TERA-TU-Graz/fennek_2019/HW/pcbs/other/button_interface/button_interface.png

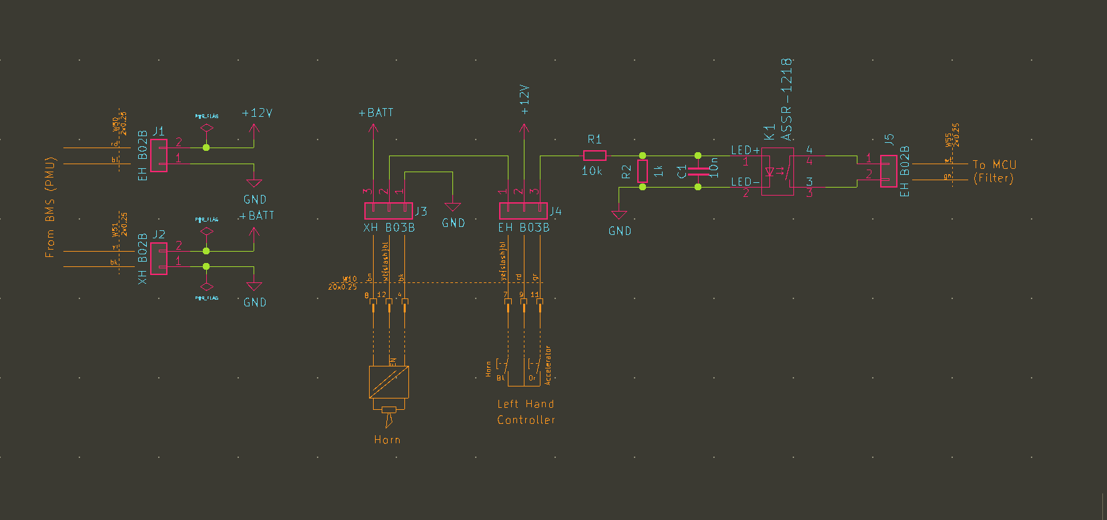
HW/pcbs/other/button_interface/button_interface.png
