TERA-TU-Graz/fennek_2019/HW/pcbs/motor/V8/Motor-Control-board-V8_1_KiCAD/gerber/Motor_Control-B.Cu.pdf

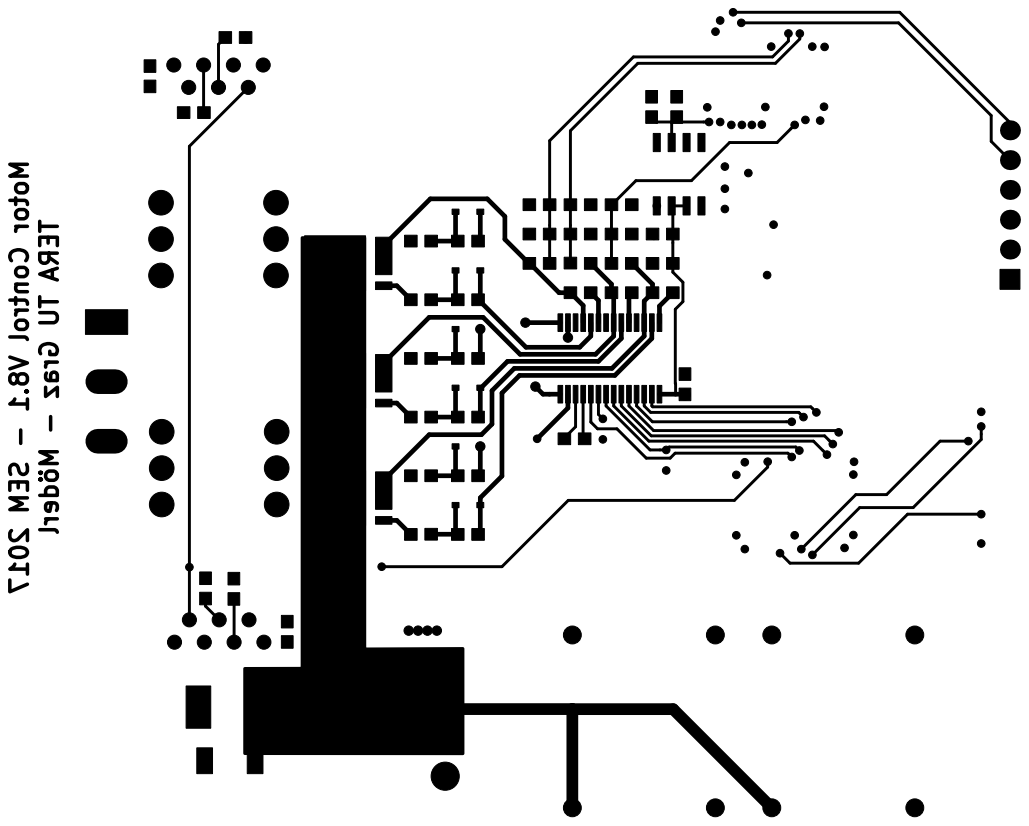
[picture p2: page 1]

Motor Control V8.1 - SEM 2017 TERA TU Graz - Möderl
