TERA-TU-Graz/fennek_2019/HW/pcbs/motor/V8/Motor-Control-board-V8_1_KiCAD/gerber/Motor_Control-B.Mask.pdf

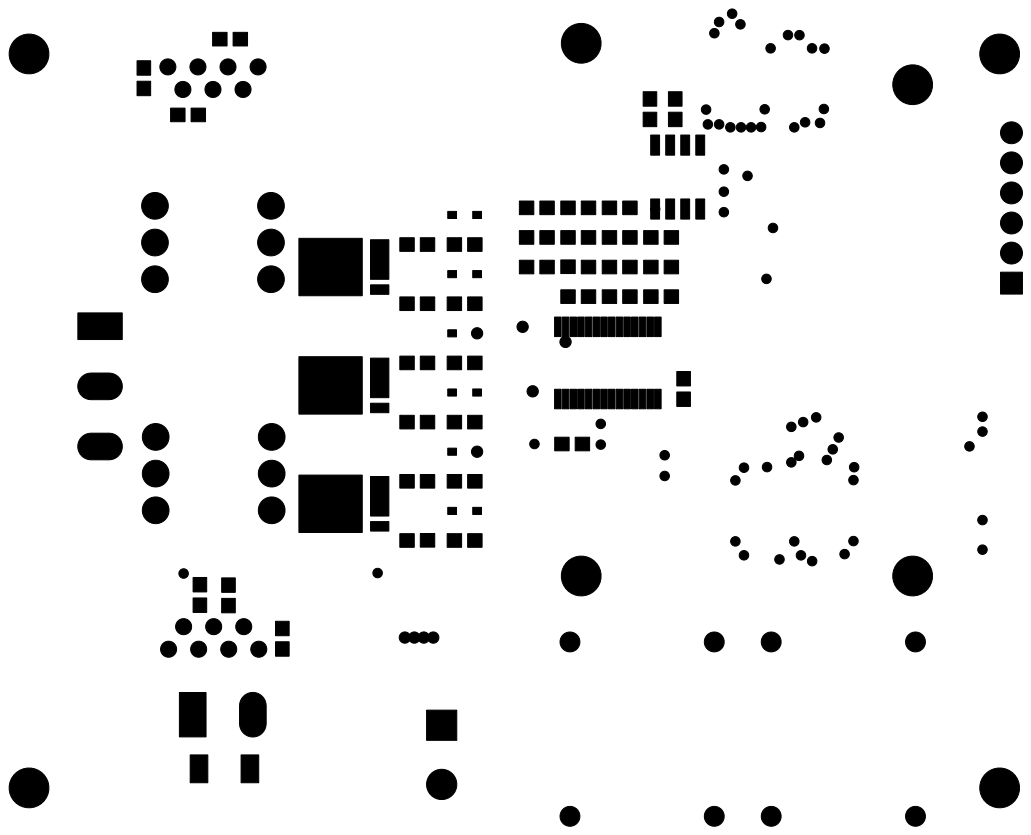
[picture p3: page 1]
