TERA-TU-Graz/fennek_2019/HW/pcbs/motor/V8/Motor-Control-board-V8_1_KiCAD/gerber/Motor_Control-F.Cu.pdf

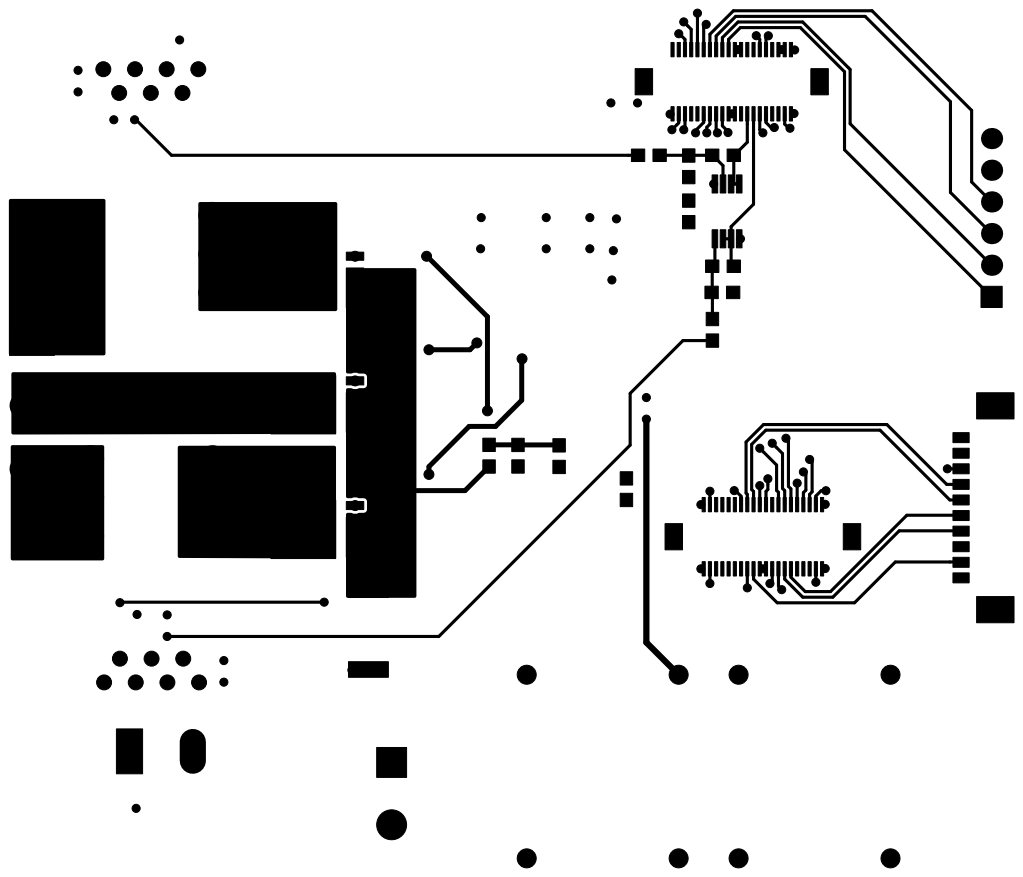
[picture p5: page 1]
