TERA-TU-Graz/fennek_2019/HW/pcbs/BMS/measurement_and_balancing/bms_board_V6-1__12s_fennek2017/bms_board.kicad_pcb

## KiCad design HW/pcbs/BMS/measurement_and_balancing/bms_board_V6-1__12s_fennek2017/bms_board.kicad_pcb (2020-02-26)

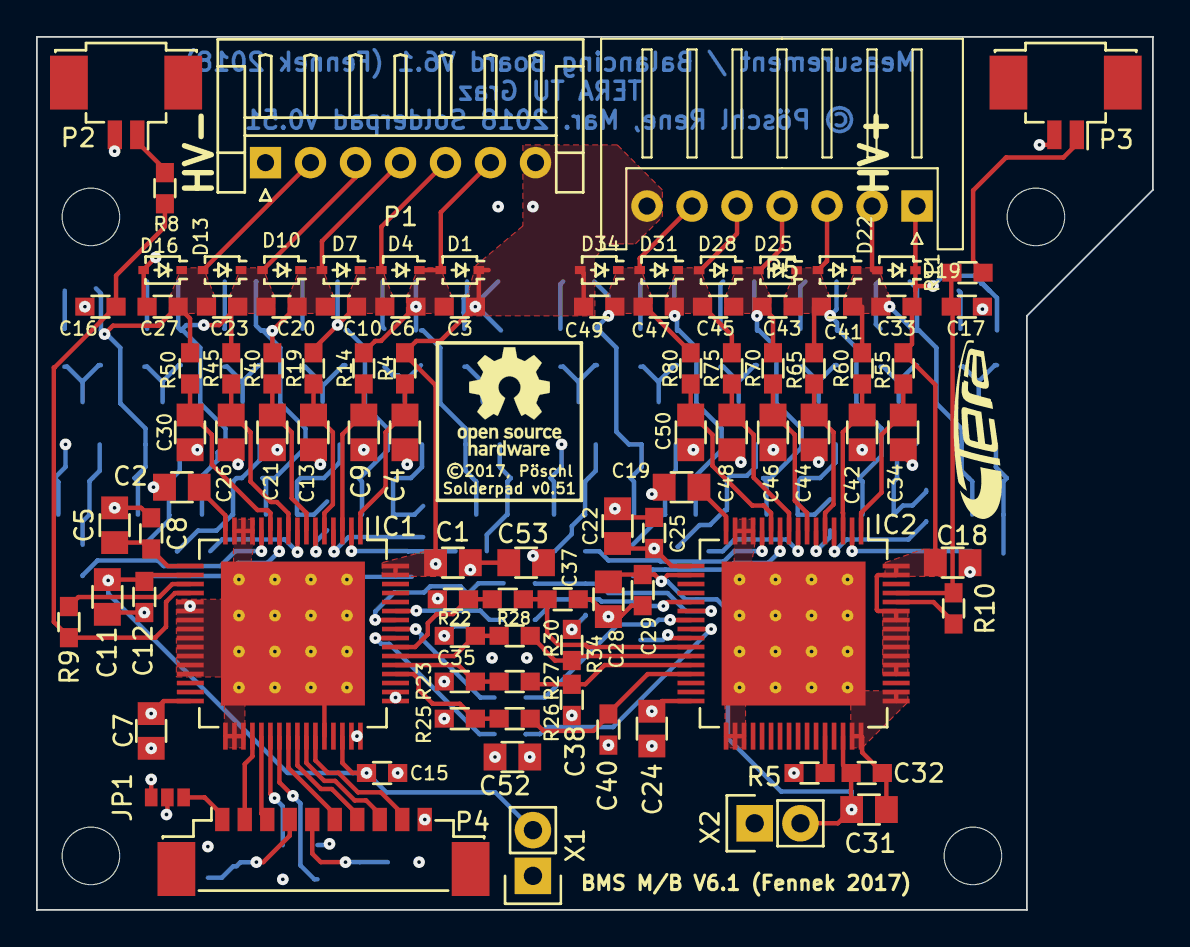
[picture p10: board bms_board.kicad_pcb from above]

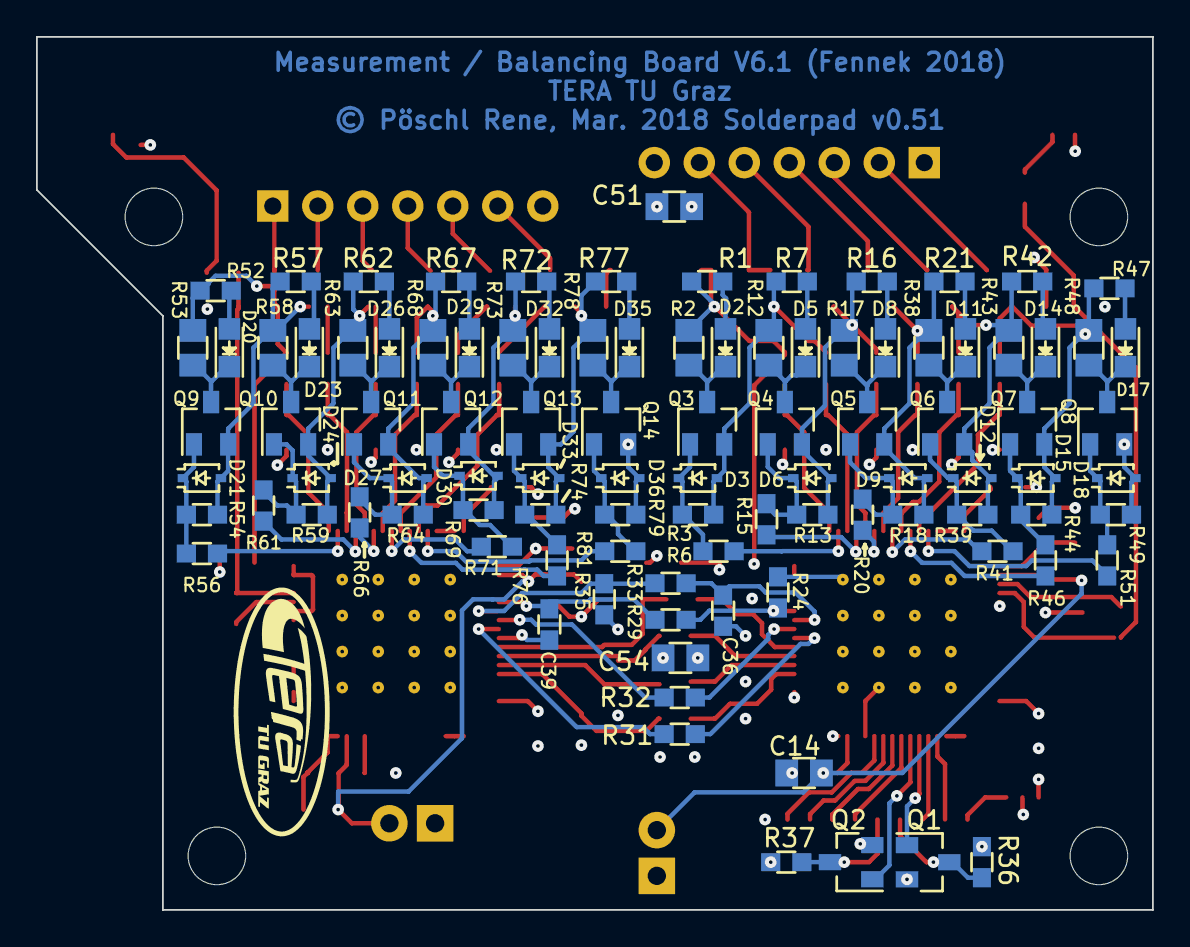
[picture p11: board bms_board.kicad_pcb from below]

Board: 4 copper layers, 62.0 x 48.5 mm, 197 parts (100 on the bottom side), 116 nets.

Parts:
C1, C4, C9, C13, C18, C21, C26, C30, C34, C42, C44, C46, C48, C50, C51, C52, C53, C54: 100n 50V; C_0805in
C2, C19: 10u; C_0805in
C3, C6, C8, C10, C12, C15, C20, C23, C25, C27, C29, C32, C33, C41, C43, C45, C47, C49: 100n; C_0603in
C5, C7, C11, C14, C22, C24, C28, C31: 2.2u; C_0805in
C16, C17: 47n; C_0603in
C35, C36, C37, C38, C39, C40: 33p; C_0603in
D1, D3, D4, D6, D7, D9, D10, D12, D13, D15, D16, D18, D19, D21, D22, D24, D25, D27, D28, D30, D31, D33, D34, D36: 5.1V; SOD-323
D2, D5, D8, D11, D14, D17, D20, D23, D26, D29, D32, D35: LED; LED_0805
IC1, IC2: TI-bq76pl536; TI_bq76PL536
JP1: JUMPER3_NO; SOLDERJUMPER_3_1mm
P1: CONN_01X07; JST_EH_S07B-EH_07x2.50mm_Angled
P2: TS1; Molex_PicoBlade_53261-0271_02x1.25mm_Angled
P3: TS2; Molex_PicoBlade_53261-0271_02x1.25mm_Angled
P4: Host_Interface; Molex_PicoBlade_53398-1071_10x1.25mm_Straight
P5: CONN_01X07; JST_XH_S07B-XH-A_07x2.50mm_Angled
Q1, Q2, Q3, Q4, Q5, Q6, Q7, Q8, Q9, Q10, Q11, Q12, Q13, Q14: BSS205N
R1, R7, R16, R21, R42, R47, R52, R57, R62, R67, R72, R77: 2K2; R_0603in
R2, R12, R17, R38, R43, R48, R53, R58, R63, R68, R73, R78: 180R; R_0805in
R3, R13, R18, R22, R23, R24, R25, R39, R44, R49, R54, R59, R64, R69, R74, R79: 2M; R_0603in
R4, R6, R14, R15, R19, R20, R26, R27, R28, R29, R30, R31, R32, R33, R40, R41, R45, R46, R50, R51, R55, R56, R60, R61, R65, R66, R70, R71, R75, R76, R80, R81: 1K; R_0603in
R5: 100K; R_0603in
R8, R11: 1.47K; R_0603in
R9, R10: 1.82K; R_0603in
R34, R35: 510K; R_0603in
R36, R37: 10K; R_0603in
X1, X2: Prog_Voltage; Socket_Strip_Straight_1x02
svg2mod: G***; TERA_Logo_SilkS_5x12.5mm
svg2mod#2: G***; TERA_TextOnly_SilkS_2.5x9.5mm

Connections:
+5V: C7.1, C16.1, IC1.32, JP1.1, P2.2
+BATT: C18.2, C33.1, D19.1, IC2.52, IC2.53, IC2.54, IC2.55, IC2.56, IC2.57, IC2.58, IC2.59, IC2.63, IC2.64, P5.1, R52.1, R53.1, R55.2
/5V_C2: C17.1, C24.1, IC2.32, P3.2, R34.1, R35.1
/Chip1/+5V_LDOA: C5.1, C8.1, IC1.17
/Chip1/Alert_H: IC1.38, Q1.1
/Chip1/BalanceCell1/VCn: C30.1, IC1.11, R50.1
/Chip1/BalanceCell2/VCn: C26.1, IC1.9, R45.1
/Chip1/BalanceCell3/VCn: C21.1, IC1.7, R40.1
/Chip1/BalanceCell4/VCn: C13.1, IC1.5, R19.1
/Chip1/BalanceCell5/VCn: C9.1, IC1.3, R14.1
/Chip1/BalanceCell6/VCn: C4.1, IC1.1, R4.1
/Chip1/CB1: IC1.12, R51.1
/Chip1/CB2: IC1.10, R46.1
/Chip1/CB3: IC1.8, R41.1
/Chip1/CB4: IC1.6, R20.1
/Chip1/CB5: IC1.4, R15.1
/Chip1/CB6: IC1.2, R6.1
/Chip1/CONV_H: IC1.36, P4.2
/Chip1/CS_H: IC1.43, P4.9
/Chip1/DRDY_H: IC1.37, P4.3
/Chip1/Fault_H: IC1.39, Q2.1
/Chip1/LDODx: C11.1, C12.1, C14.1, C15.1, IC1.18, IC1.46, X1.2
/Chip1/SCLK_H: IC1.40, P4.6
/Chip1/SDI_H: IC1.42, P4.8
/Chip1/SDO_H: IC1.41, P4.7
/Chip1/TS1+: C16.2, IC1.20, R8.1, R9.1
/Chip1/TS1-: IC1.19, R9.2
/Chip1/VC1: C23.2, C27.1, D13.2, D15.2, D16.1, P1.2, Q7.2, R44.2, R47.1, R48.1, R50.2
/Chip1/VC2: C20.2, C23.1, D10.2, D12.2, D13.1, P1.3, Q6.2, R39.2, R42.1, R43.1, R45.2
/Chip1/VC3: C10.2, C20.1, D7.2, D9.2, D10.1, P1.4, Q5.2, R18.2, R21.1, R38.1, R40.2
/Chip1/VC4: C6.2, C10.1, D4.2, D6.2, D7.1, P1.5, Q4.2, R13.2, R16.1, R17.1, R19.2
/Chip1/VC5: C3.2, C6.1, D1.2, D3.2, D4.1, P1.6, Q3.2, R3.2, R7.1, R12.1, R14.2
/Chip2/+5V_LDOA: C22.1, C25.1, IC2.17, R5.1
/Chip2/BalanceCell1/VCn: C50.1, IC2.11, R80.1
/Chip2/BalanceCell2/VCn: C48.1, IC2.9, R75.1
/Chip2/BalanceCell3/VCn: C46.1, IC2.7, R70.1
/Chip2/BalanceCell4/VCn: C44.1, IC2.5, R65.1
/Chip2/BalanceCell5/VCn: C42.1, IC2.3, R60.1
/Chip2/BalanceCell6/VCn: C34.1, IC2.1, R55.1
/Chip2/CB1: IC2.12, R81.1
/Chip2/CB2: IC2.10, R76.1
/Chip2/CB3: IC2.8, R71.1
/Chip2/CB4: IC2.6, R66.1
/Chip2/CB5: IC2.4, R61.1
/Chip2/CB6: IC2.2, R56.1
/Chip2/HSEL: IC2.44, R5.2
/Chip2/LDODx: C28.1, C29.1, C31.1, C32.1, IC2.18, IC2.46, X2.2
/Chip2/TS2+: C17.2, IC2.61, R10.1, R11.1
/Chip2/TS2-: IC2.60, R10.2
/Chip2/VC1: C47.2, C49.1, D31.2, D33.2, D34.1, P5.6, Q13.2, R74.2, R77.1, R78.1, R80.2
/Chip2/VC2: C45.2, C47.1, D28.2, D30.2, D31.1, P5.5, Q12.2, R69.2, R72.1, R73.1, R75.2
/Chip2/VC3: C43.2, C45.1, D25.2, D27.2, D28.1, P5.4, Q11.2, R64.2, R67.1, R68.1, R70.2
/Chip2/VC4: C41.2, C43.1, D22.2, D24.2, D25.1, P5.3, Q10.2, R59.2, R62.1, R63.1, R65.2
/Chip2/VC5: C33.2, C41.1, D19.2, D21.2, D22.1, P5.2, Q9.2, R54.2, R57.1, R58.1, R60.2
/Daisychain/Alert_1: IC1.57, R32.1
/Daisychain/Alert_2: IC2.23, R32.2
/Daisychain/CONV_1: IC1.59, R24.2, R29.1
/Daisychain/CONV_2: C39.1, IC2.21, R29.2
/Daisychain/CS_1: IC1.52, R25.2, R26.1
/Daisychain/CS_2: C40.1, IC2.29, R26.2
/Daisychain/DRDY_1: C36.2, IC1.58, R33.1
/Daisychain/DRDY_2: IC2.22, R33.2, R35.2
/Daisychain/Fault_1: IC1.56, R31.1
/Daisychain/Fault_2: IC2.24, R31.2
/Daisychain/SCLK_1: IC1.55, R22.2, R28.1
/Daisychain/SCLK_2: C37.1, IC2.26, R28.2
/Daisychain/SDI_1: IC1.53, R23.2, R27.1
/Daisychain/SDI_2: C38.1, IC2.28, R27.2
/Daisychain/SDO_1: C35.2, IC1.54, R30.1
/Daisychain/SDO_2: IC2.27, R30.2, R34.2
/Host_connect/+5V_DO: JP1.2, R36.1, R37.1
/Host_connect/+5V_Host: JP1.3, P4.1
/Host_connect/NALERT_H: P4.4, Q1.3, R36.2
/Host_connect/NFAULT_H: P4.5, Q2.3, R37.2
GND: C1.1, C2.2, C4.2, C5.2, C7.2, C8.2, C9.2, C11.2, C12.2, C13.2, C14.2, C15.2, C21.2, C26.2, C27.2, C30.2, C51.2, C52.2, C53.2, C54.2, D16.2, D18.2, IC1.13, IC1.14, IC1.15, IC1.21, IC1.22, IC1.23, IC1.24, IC1.25, IC1.26, IC1.27, IC1.28, IC1.29, IC1.33, IC1.34, IC1.35, IC1.44, IC1.47, IC1.48, IC1.49, IC1.50, IC1.65, P1.1, P4.10, Q1.2, Q2.2, Q8.2, R22.1, R23.1, R24.1, R25.1, R49.2, X1.1
unnamed: C2.1, IC1.16
unnamed: C19.1, IC2.16
unnamed: D2.1, Q3.3, R2.2
unnamed: D2.2, R1.2
unnamed: D3.1, Q3.1, R3.1, R6.2
unnamed: D5.1, Q4.3, R12.2
unnamed: D5.2, R7.2
unnamed: D6.1, Q4.1, R13.1, R15.2
unnamed: D8.1, Q5.3, R17.2
unnamed: D8.2, R16.2
unnamed: D9.1, Q5.1, R18.1, R20.2
unnamed: D11.1, Q6.3, R38.2
unnamed: D11.2, R21.2
unnamed: D12.1, Q6.1, R39.1, R41.2
unnamed: D14.1, Q7.3, R43.2
unnamed: D14.2, R42.2
unnamed: D15.1, Q7.1, R44.1, R46.2
unnamed: D17.1, Q8.3, R48.2
unnamed: D17.2, R47.2
unnamed: D18.1, Q8.1, R49.1, R51.2
unnamed: D20.1, Q9.3, R53.2
unnamed: D20.2, R52.2
unnamed: D21.1, Q9.1, R54.1, R56.2
unnamed: D23.1, Q10.3, R58.2
unnamed: D23.2, R57.2
unnamed: D24.1, Q10.1, R59.1, R61.2
unnamed: D26.1, Q11.3, R63.2
unnamed: D26.2, R62.2
unnamed: D27.1, Q11.1, R64.1, R66.2
unnamed: D29.1, Q12.3, R68.2
unnamed: D29.2, R67.2
unnamed: D30.1, Q12.1, R69.1, R71.2
unnamed: D32.1, Q13.3, R73.2
unnamed: D32.2, R72.2
unnamed: D33.1, Q13.1, R74.1, R76.2
unnamed: D35.1, Q14.3, R78.2
unnamed: D35.2, R77.2
unnamed: D36.1, Q14.1, R79.1, R81.2
unnamed: P2.1, R8.2
unnamed: P3.1, R11.2
Vmiddle: C1.2, C3.1, C18.1, C19.2, C22.2, C24.2, C25.2, C28.2, C29.2, C31.2, C32.2, C34.2, C35.1, C36.1, C37.2, C38.2, C39.2, C40.2, C42.2, C44.2, C46.2, C48.2, C49.2, C50.2, C51.1, C52.1, C53.1, C54.1, D1.1, D34.2, D36.2, IC1.63, IC1.64, IC2.13, IC2.14, IC2.15, IC2.25, IC2.33, IC2.34, IC2.35, IC2.47, IC2.48, IC2.49, IC2.50, IC2.65, P1.7, P5.7, Q14.2, R1.1, R2.1, R4.2, R79.2, X2.1
