TERA-TU-Graz/fennek_2019/HW/pcbs/motor/V8/Motor-Control-board-V8_1_KiCAD/Motor_Control.kicad_pcb

## KiCad design HW/pcbs/motor/V8/Motor-Control-board-V8_1_KiCAD/Motor_Control.kicad_pcb (2020-02-26, an earlier design)

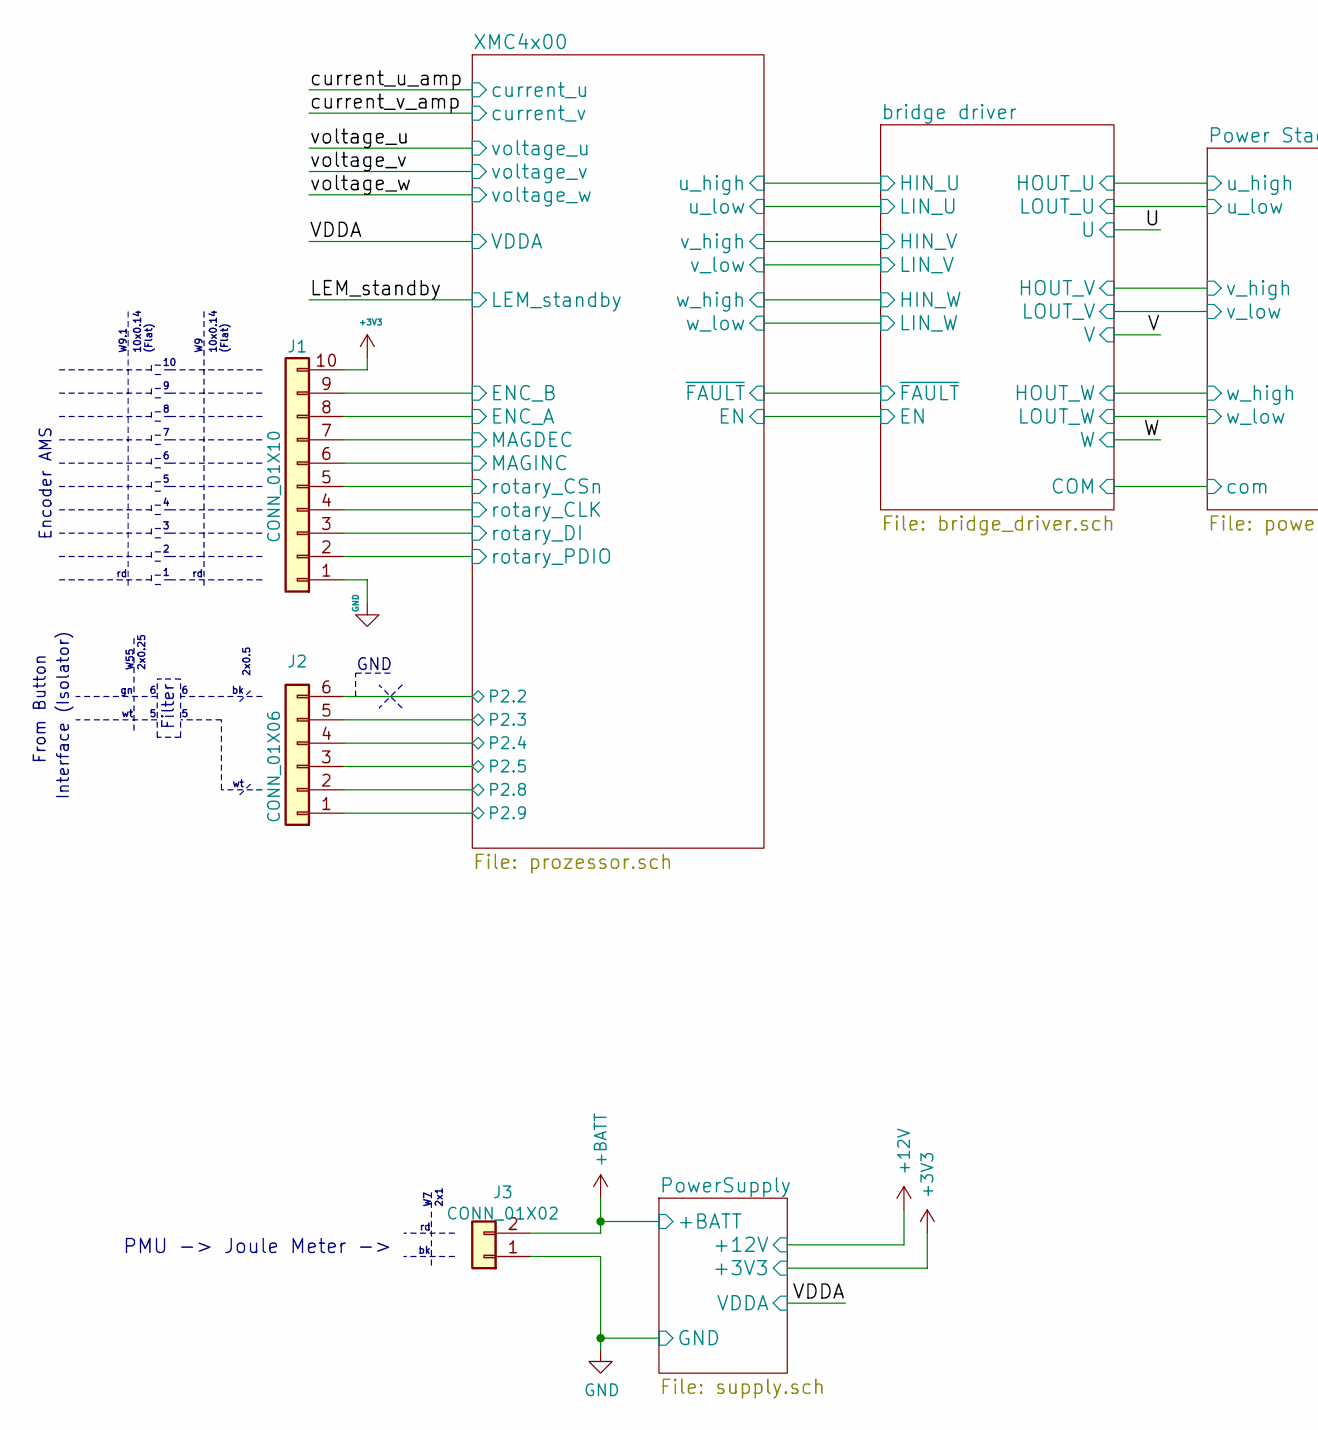
[picture p12: schematic Motor_Control.sch, Motor Control, part in row 1, column 1]

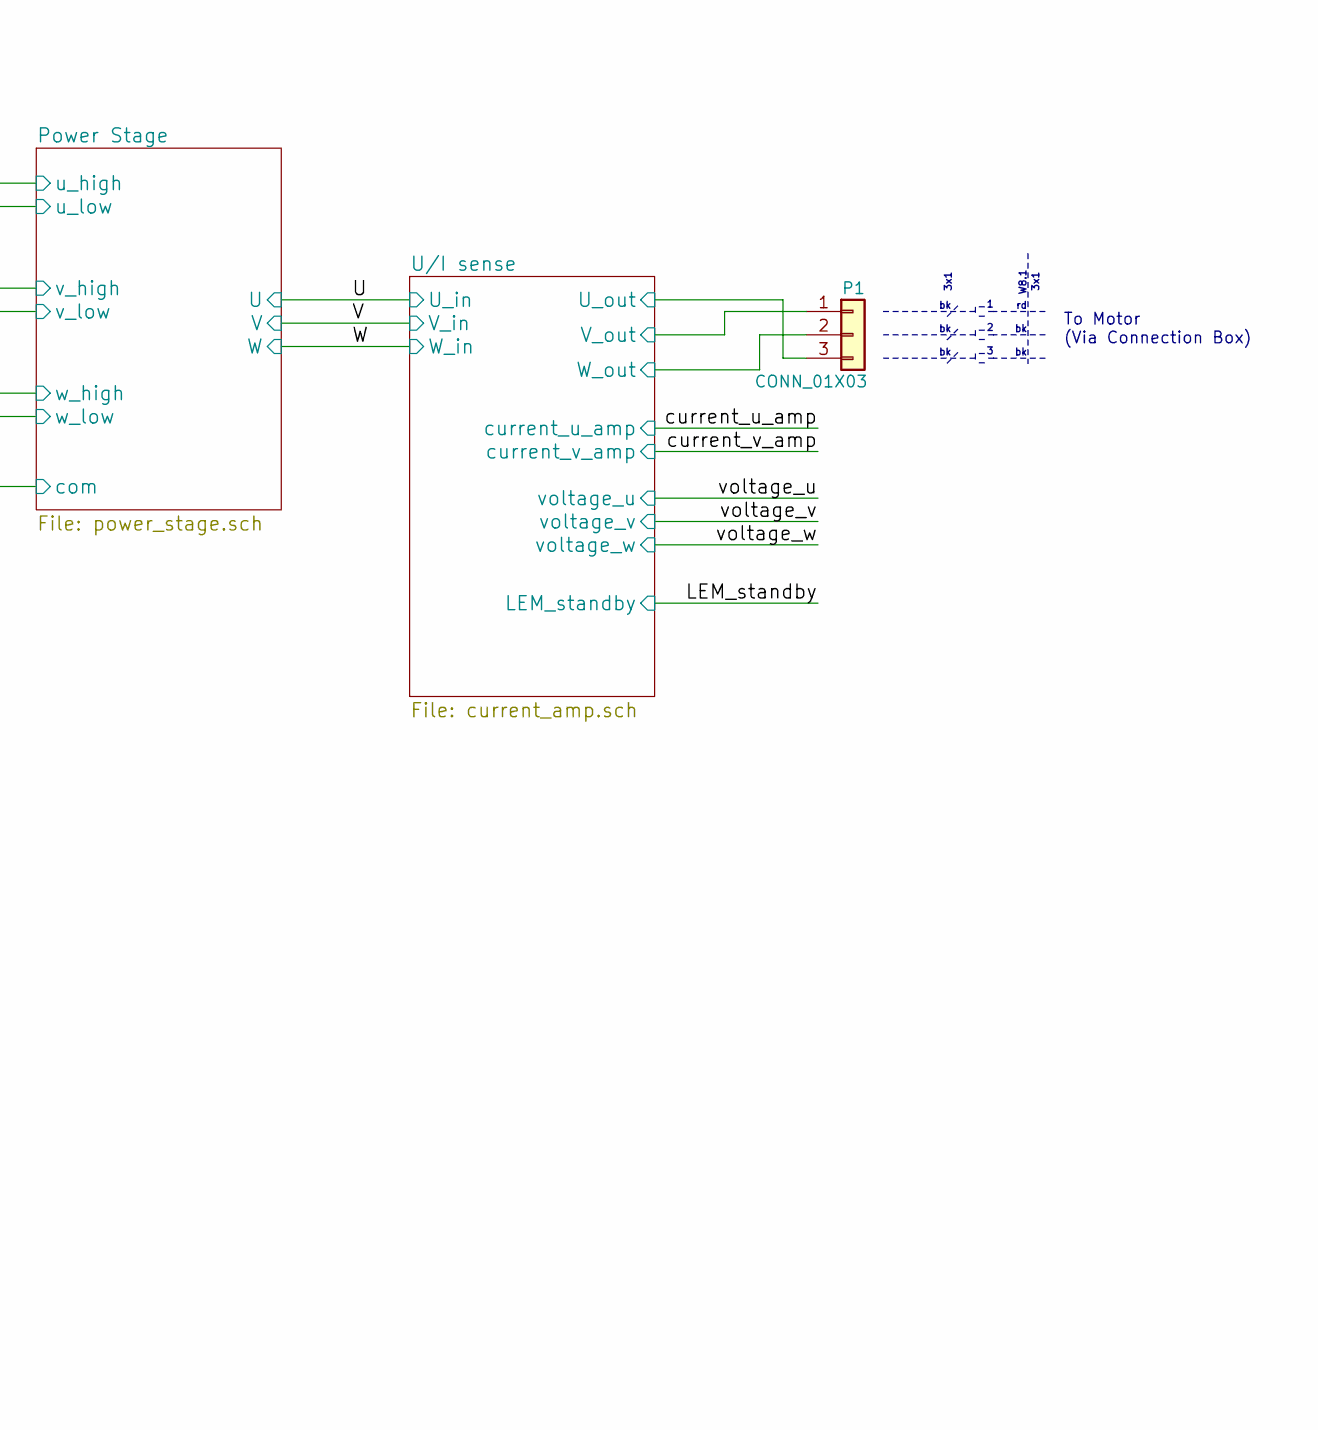
[picture p13: schematic Motor_Control.sch, Motor Control, part in row 1, column 2]

Parts:
J1: CONN_01X10; Molex_PicoBlade_53398-1071_10x1.25mm_Straight
J2: CONN_01X06; Pin_Header_Straight_1x06_Pitch2.54mm
J3: CONN_01X02; PhoenixContact_MSTB-GF_02x5.08mm_Angled_ThreadedFlange
P1: CONN_01X03; PhoenixContact_MSTBA-G_03x5.08mm_Angled

Connections:
+3V3: J1.10; also elsewhere on the board
+BATT: J3.2; also elsewhere on the board
<root sheet>ENC_A: J1.8; also elsewhere on the board
<root sheet>ENC_B: J1.9; also elsewhere on the board
<root sheet>MAGDEC: J1.7; also elsewhere on the board
<root sheet>MAGINC: J1.6; also elsewhere on the board
<root sheet>U_out: P1.3; also elsewhere on the board
<root sheet>V_out: P1.1; also elsewhere on the board
<root sheet>W_out: P1.2; also elsewhere on the board
<root sheet>rotary_CLK: J1.4; also elsewhere on the board
<root sheet>rotary_CSn: J1.5; also elsewhere on the board
<root sheet>rotary_DI: J1.3; also elsewhere on the board
<root sheet>rotary_PDIO: J1.2; also elsewhere on the board
GND: J1.1, J3.1; also elsewhere on the board
unnamed 58: J2.1; also elsewhere on the board
unnamed 59: J2.2; also elsewhere on the board
unnamed 60: J2.3; also elsewhere on the board
unnamed 61: J2.4; also elsewhere on the board
unnamed 62: J2.5; also elsewhere on the board
unnamed 63: J2.6; also elsewhere on the board

Notes on the sheet:
10x0.14 (Flat)
W9.1
Encoder AMS
3x1
W8.1
To Motor (Via Connection Box)
PMU -> Joule Meter ->
2x1
GND
2x0.5
Filter
From Button
Interface (Isolator)
2x0.25
W55

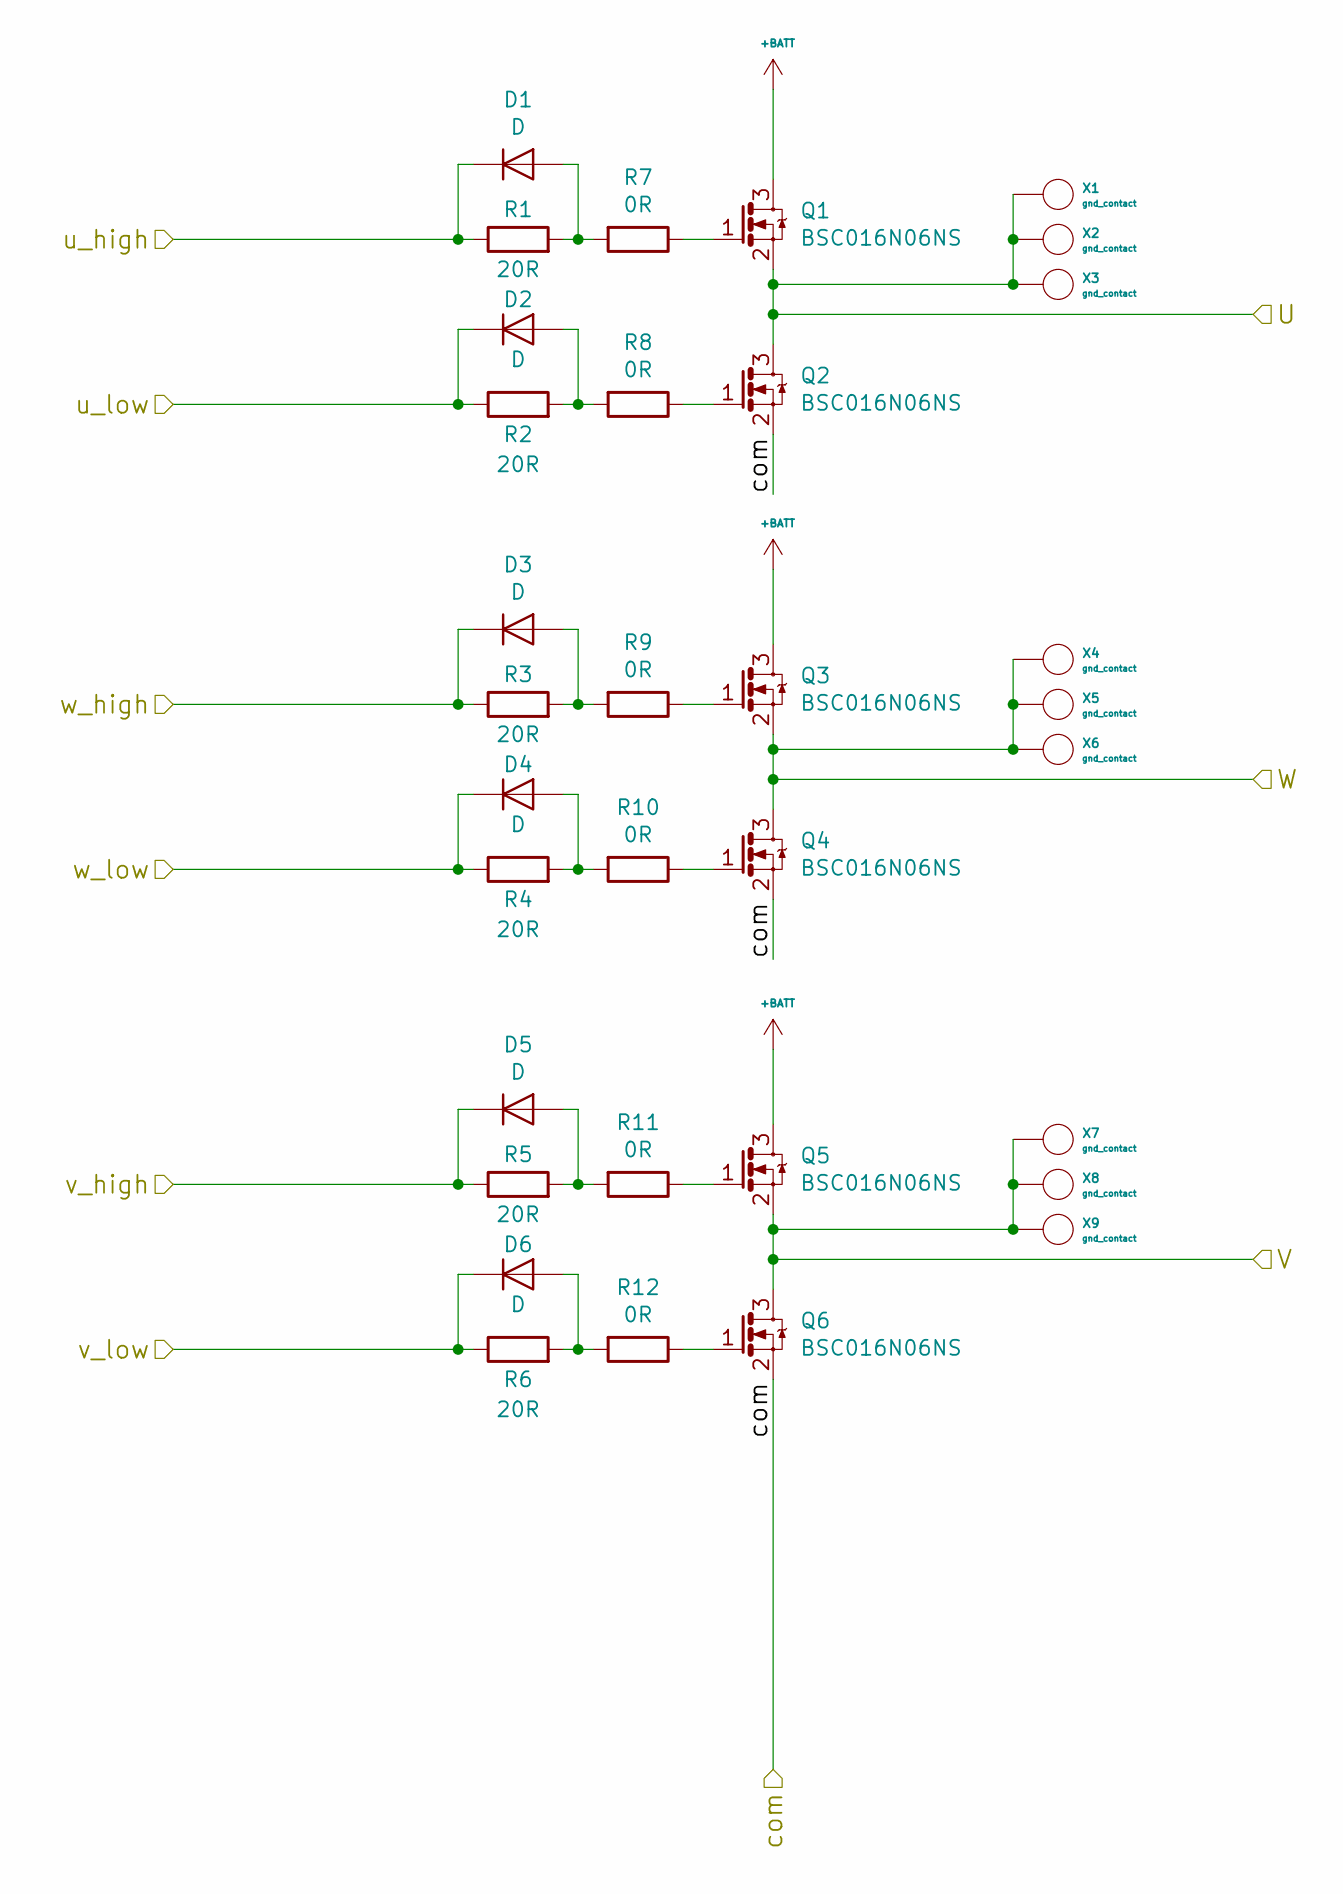
[picture p14: schematic power_stage.sch, Motor Control]

Parts:
D1, D2, D3, D4, D5, D6: D; SOD-323
Q1, Q2, Q3, Q4, Q5, Q6: BSC016N06NS; INF-PG-TDSON-8
R1, R2, R3, R4, R5, R6: 20R; R_0603in
R7, R8, R9, R10, R11, R12: 0R; R_0603in
X1, X2, X3, X4, X5, X6, X7, X8, X9: gnd_contact; via_0.4mm

Connections:
+BATT: Q1.3 (D), Q3.3 (D), Q5.3 (D); also elsewhere on the board
<root sheet>COM: Q2.2 (S), Q4.2 (S), Q6.2 (S); also elsewhere on the board
<root sheet>HOUT_V: D5.1 (K), R5.1; also elsewhere on the board
<root sheet>LOUT_V: D6.1 (K), R6.1; also elsewhere on the board
<root sheet>U: Q1.2 (S), Q2.3 (D), X1.1, X2.1, X3.1; also elsewhere on the board
<root sheet>V: Q5.2 (S), Q6.3 (D), X7.1, X8.1, X9.1; also elsewhere on the board
<root sheet>W_out: Q3.2 (S), Q4.3 (D), X4.1, X5.1, X6.1; also elsewhere on the board
<root sheet>u_high: D1.1 (K), R1.1; also elsewhere on the board
<root sheet>u_low: D2.1 (K), R2.1; also elsewhere on the board
<root sheet>w_high: D3.1 (K), R3.1; also elsewhere on the board
<root sheet>w_low: D4.1 (K), R4.1; also elsewhere on the board
unnamed: D1.2 (A), R1.2, R7.2
unnamed: D2.2 (A), R2.2, R8.2
unnamed: D3.2 (A), R3.2, R9.2
unnamed: D4.2 (A), R4.2, R10.2
unnamed: D5.2 (A), R5.2, R11.2
unnamed: D6.2 (A), R6.2, R12.2
unnamed: Q1.1 (G), R7.1
unnamed: Q2.1 (G), R8.1
unnamed: Q3.1 (G), R9.1
unnamed: Q4.1 (G), R10.1
unnamed: Q5.1 (G), R11.1
unnamed: Q6.1 (G), R12.1

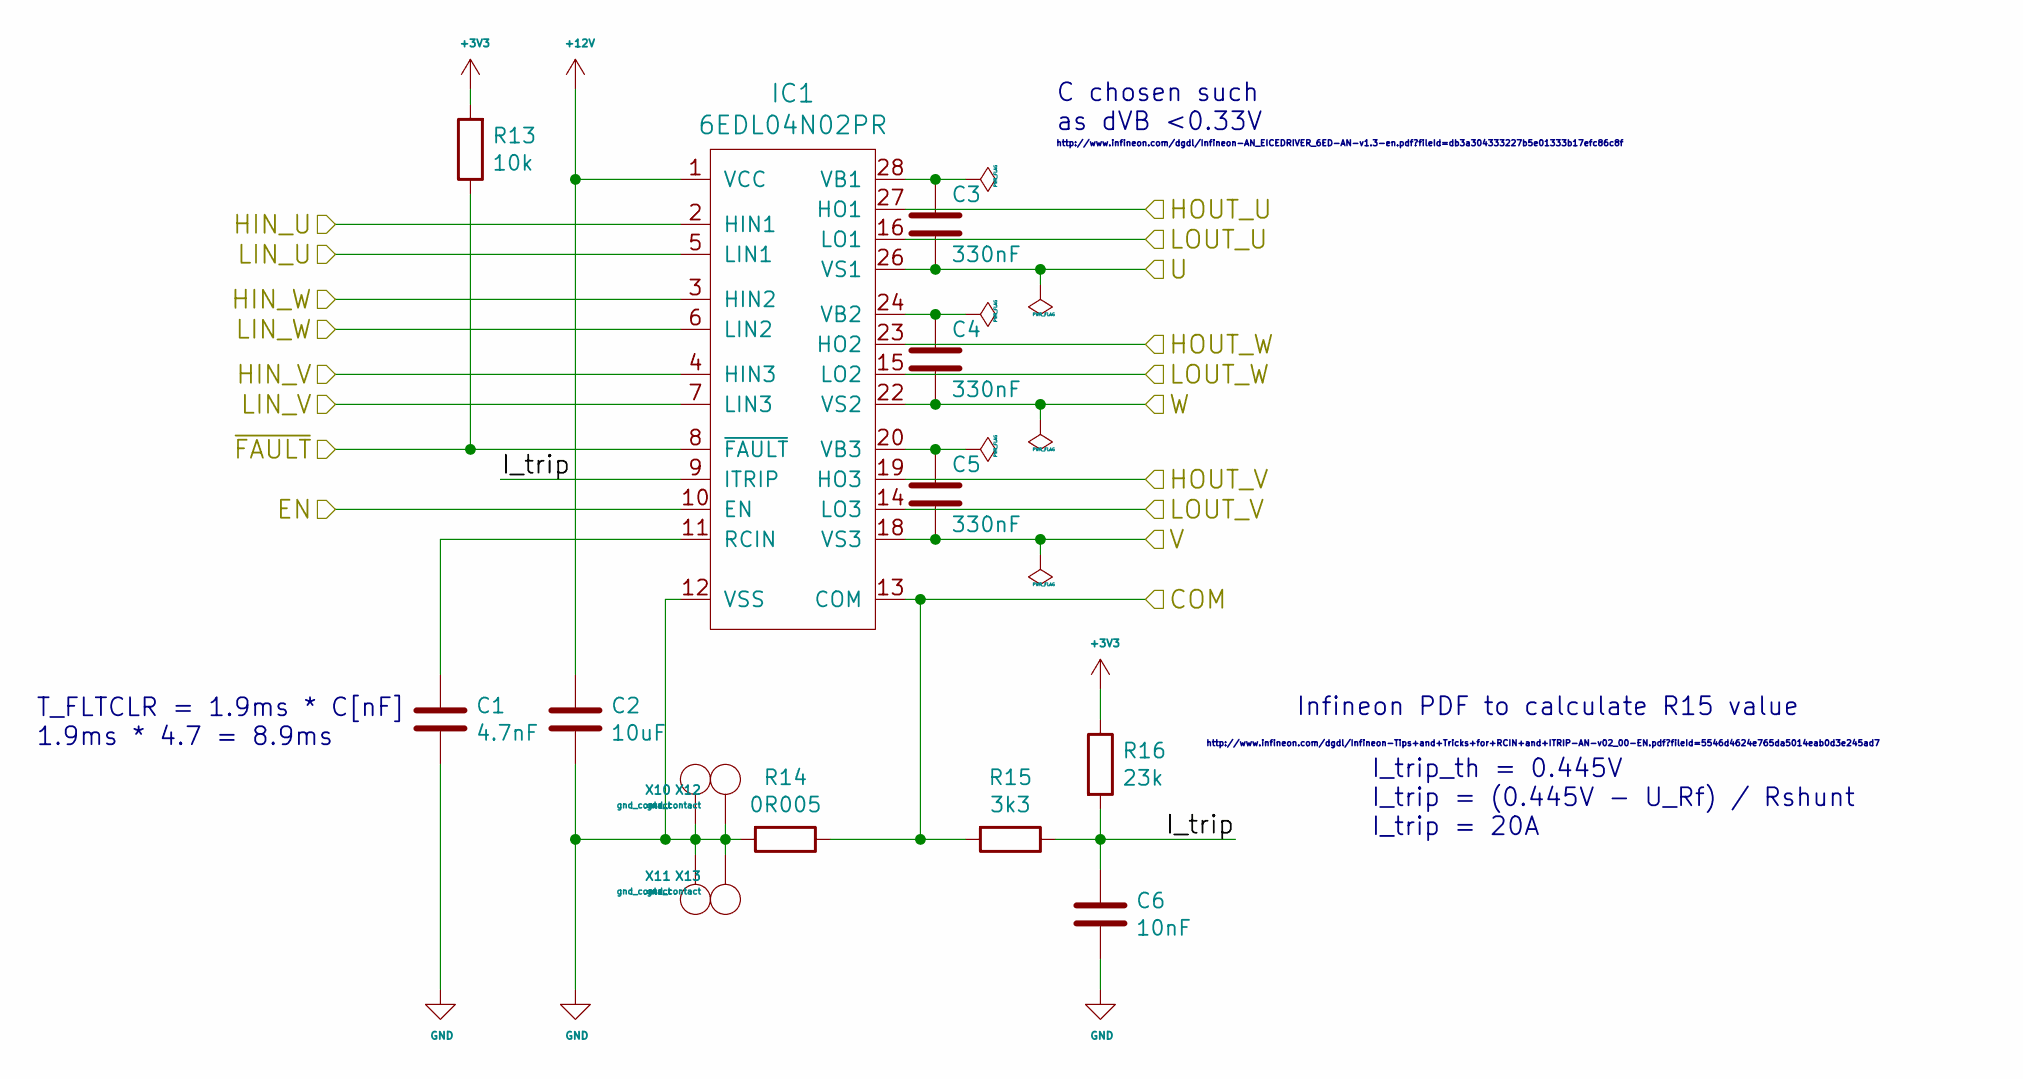
[picture p15: schematic bridge_driver.sch, Motor Control]

Parts:
C1: 4.7nF; C_0603in
C2: 10uF; C_0603in
C3, C4, C5: 330nF; C_0603in
C6: 10nF; C_0603in
IC1: 6EDL04N02PR
R13: 10k; R_0603in
R14: 0R005; R_2512in
R15: 3k3; R_0603in
R16: 23k; R_0603in
X10, X11, X12, X13: gnd_contact; via_0.4mm

Connections:
+3V3: R13.2, R16.1; also elsewhere on the board
+12V: C2.1, IC1.1 (VCC); also elsewhere on the board
/bridge driver/I_trip: C6.1, IC1.9 (ITRIP), R15.1, R16.2
<root sheet>COM: IC1.13 (COM), R14.1, R15.2; also elsewhere on the board
<root sheet>EN: IC1.10 (EN); also elsewhere on the board
<root sheet>HOUT_V: IC1.19 (HO3); also elsewhere on the board
<root sheet>LOUT_V: IC1.14 (LO3); also elsewhere on the board
<root sheet>U: C3.2, IC1.26 (VS1); also elsewhere on the board
<root sheet>V: C5.2, IC1.18 (VS3); also elsewhere on the board
<root sheet>W_out: C4.2, IC1.22 (VS2); also elsewhere on the board
<root sheet>u_high: IC1.27 (HO1); also elsewhere on the board
<root sheet>u_high_1: IC1.2 (HIN1); also elsewhere on the board
<root sheet>u_low: IC1.16 (LO1); also elsewhere on the board
<root sheet>u_low_1: IC1.5 (LIN1); also elsewhere on the board
<root sheet>v_high: IC1.4 (HIN3); also elsewhere on the board
<root sheet>v_low: IC1.7 (LIN3); also elsewhere on the board
<root sheet>w_high: IC1.23 (HO2); also elsewhere on the board
<root sheet>w_high_1: IC1.3 (HIN2); also elsewhere on the board
<root sheet>w_low: IC1.15 (LO2); also elsewhere on the board
<root sheet>w_low_1: IC1.6 (LIN2); also elsewhere on the board
<root sheet>~FAULT: IC1.8 (~FAULT), R13.1; also elsewhere on the board
GND: C1.2, C2.2, C6.2, IC1.12 (VSS), R14.2, X10.1, X11.1, X12.1, X13.1; also elsewhere on the board
unnamed: C1.1, IC1.11 (RCIN)
unnamed: C3.1, IC1.28 (VB1)
unnamed: C4.1, IC1.24 (VB2)
unnamed: C5.1, IC1.20 (VB3)

Notes on the sheet:
http://www.infineon.com/dgdl/Infineon-Tips+and+Tricks+for+RCIN+and+ITRIP-AN-v02_00-EN.pdf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
Infineon PDF to calculate R15 value
T_FLTCLR = 1.9ms * C[nF] 1.9ms * 4.7 = 8.9ms
C chosen such as dVB <0.33V
I_trip_th = 0.445V I_trip = (0.445V - U_Rf) / Rshunt I_trip = 20A
http://www.infineon.com/dgdl/Infineon-AN_EICEDRIVER_6ED-AN-v1.3-en.pdf?fileId=db3a304333227b5e01333b17efc86c8f

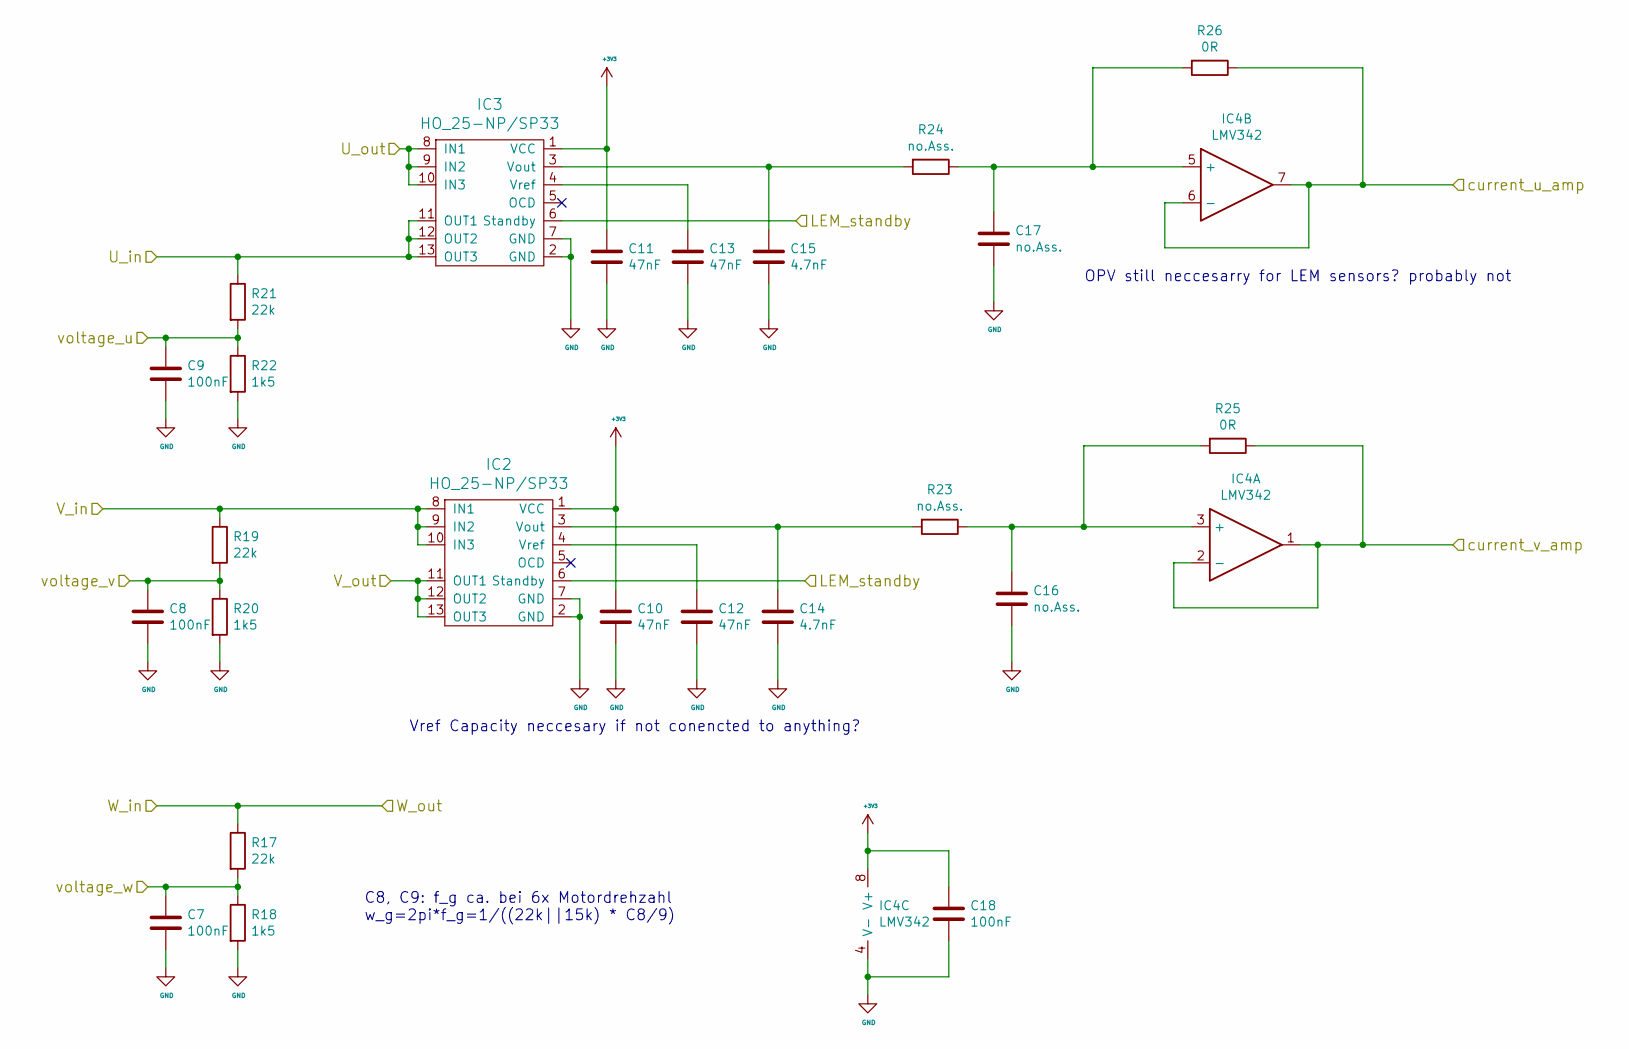
[picture p16: schematic current_amp.sch, Motor Control]

Parts:
C7, C8, C9, C18: 100nF; C_0603in
C10, C11, C12, C13: 47nF; C_0603in
C14, C15: 4.7nF; C_0603in
C16, C17: no.Ass.; C_0603in
IC2, IC3: HO_25-NP/SP33; HO_25-NP_SP33
IC4: LMV342
R17, R19, R21: 22k; R_0603in
R18, R20, R22: 1k5; R_0603in
R23, R24: no.Ass.; R_0603in
R25, R26: 0R; R_0603in

Connections:
+3V3: C10.1, C11.1, C18.1, IC2.1 (VCC), IC3.1 (VCC), IC4.8 (V+); also elsewhere on the board
<root sheet>LEM_standby: IC2.6 (Standby), IC3.6 (Standby); also elsewhere on the board
<root sheet>U: IC3.11 (OUT1), IC3.12 (OUT2), IC3.13 (OUT3), R21.1; also elsewhere on the board
<root sheet>U_out: IC3.8 (IN1), IC3.9 (IN2), IC3.10 (IN3); also elsewhere on the board
<root sheet>V: IC2.8 (IN1), IC2.9 (IN2), IC2.10 (IN3), R19.1; also elsewhere on the board
<root sheet>V_out: IC2.11 (OUT1), IC2.12 (OUT2), IC2.13 (OUT3); also elsewhere on the board
<root sheet>W_out: R17.1; also elsewhere on the board
<root sheet>current_u_amp: IC4.6 (-), IC4.7, R26.1; also elsewhere on the board
<root sheet>current_v_amp: IC4.1, IC4.2 (-), R25.1; also elsewhere on the board
<root sheet>voltage_u: C9.1, R21.2, R22.1; also elsewhere on the board
<root sheet>voltage_v: C8.1, R19.2, R20.1; also elsewhere on the board
<root sheet>voltage_w: C7.1, R17.2, R18.1; also elsewhere on the board
GND: C7.2, C8.2, C9.2, C10.2, C11.2, C12.2, C13.2, C14.2, C15.2, C16.2, C17.2, C18.2, IC2.2 (GND), IC2.7 (GND), IC3.2 (GND), IC3.7 (GND), IC4.4 (V-), R18.2, R20.2, R22.2; also elsewhere on the board
unnamed: C12.1, IC2.4 (Vref)
unnamed: C13.1, IC3.4 (Vref)
unnamed: C14.1, IC2.3 (Vout), R23.2
unnamed: C15.1, IC3.3 (Vout), R24.2
unnamed: C16.1, IC4.3 (+), R23.1, R25.2
unnamed: C17.1, IC4.5 (+), R24.1, R26.2

Notes on the sheet:
OPV still neccesarry for LEM sensors? probably not
Vref Capacity neccesary if not conencted to anything?
C8, C9: f_g ca. bei 6x Motordrehzahl w_g=2pi*f_g=1/((22k||15k) * C8/9)

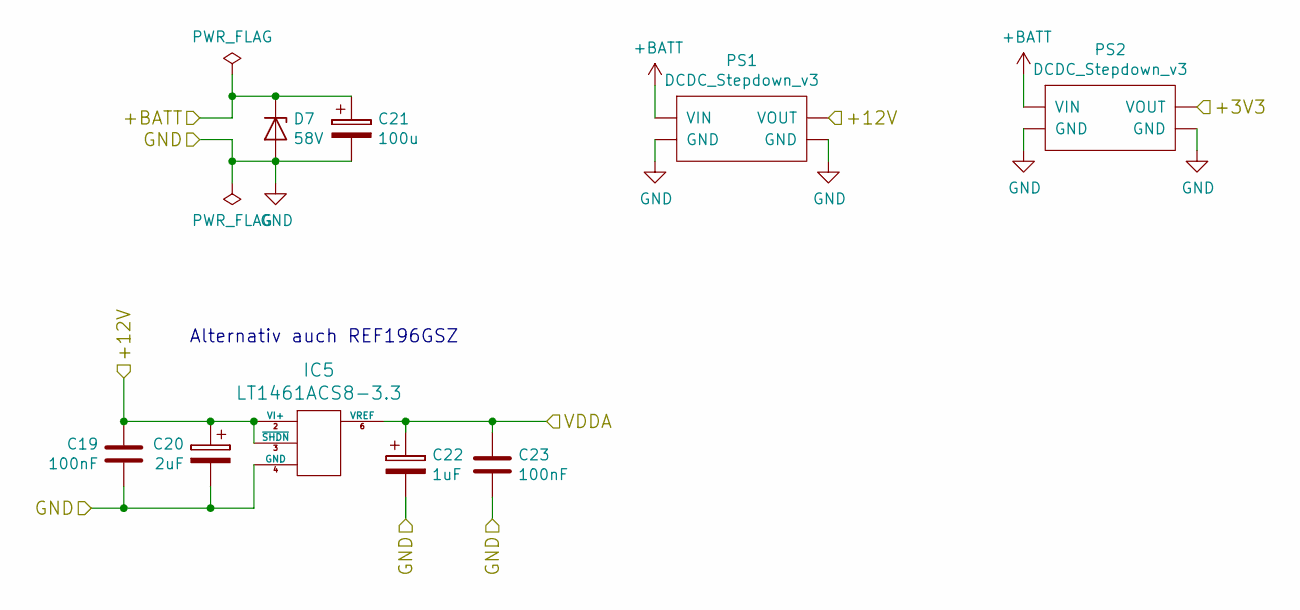
[picture p17: schematic supply.sch, Motor Control]

Parts:
C19, C23: 100nF; C_0603in
C20: 2uF; C_0603in
C21: 100u; ElkoC-12.5x20mm
C22: 1uF; C_0603in
D7: 58V; DO-214AA
IC5: LT1461ACS8-3.3; LT1461ACS8
PS1, PS2: DCDC_Stepdown_v3

Connections:
+3V3: PS2.2 (VOUT); also elsewhere on the board
+12V: C19.1, C20.1, IC5.2 (VI+), IC5.3 (~SHDN), PS1.2 (VOUT); also elsewhere on the board
+BATT: C21.1, D7.1 (K), PS1.1 (VIN), PS2.1 (VIN); also elsewhere on the board
<root sheet>VDDA: C22.1, C23.1, IC5.6 (VREF); also elsewhere on the board
GND: C19.2, C20.2, C21.2, C22.2, C23.2, D7.2 (A), IC5.4 (GND), PS1.3 (GND), PS1.4 (GND), PS2.3 (GND), PS2.4 (GND); also elsewhere on the board

Notes on the sheet:
Alternativ auch REF196GSZ
