TERA-TU-Graz/fennek_2019/HW/pcbs/motor/V8/Motor-Control-board-V8_1_KiCAD/Motor_Control.kicad_pcb

## KiCad design HW/pcbs/motor/V8/Motor-Control-board-V8_1_KiCAD/Motor_Control.kicad_pcb (continued)

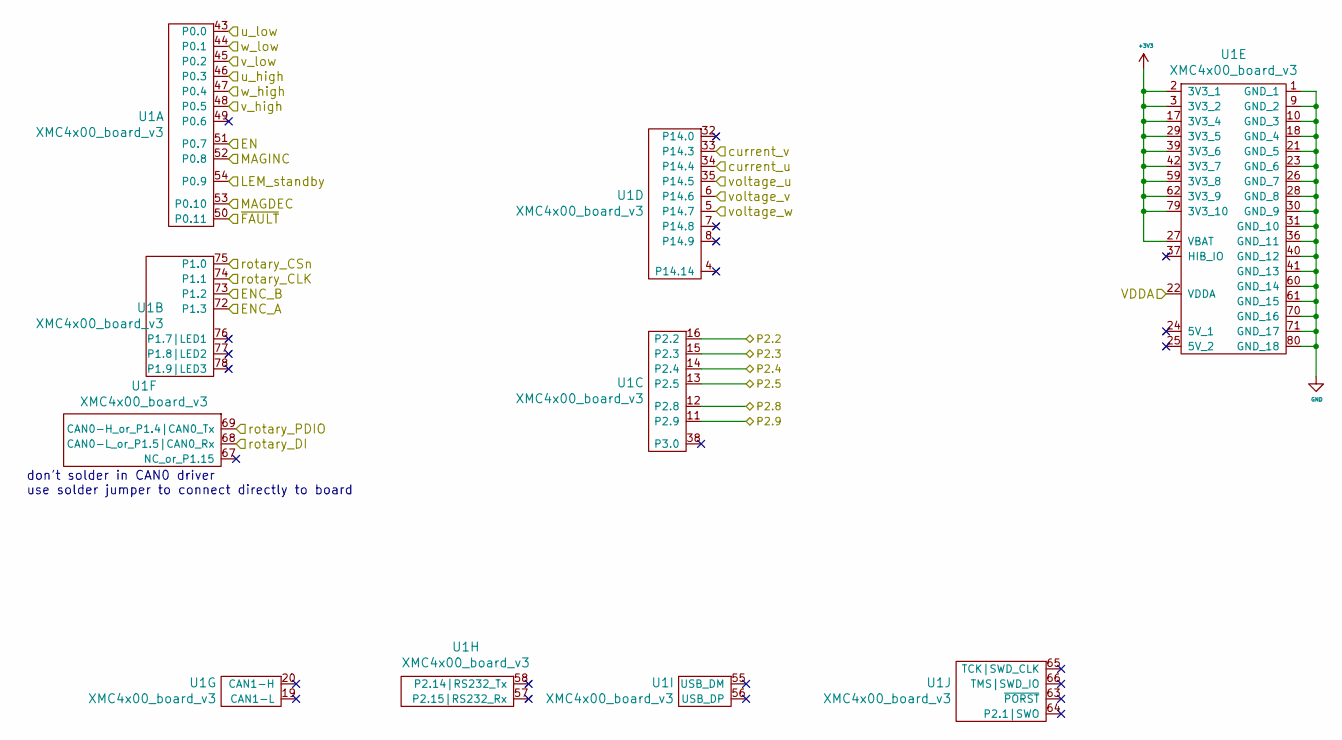
[picture p18: schematic prozessor.sch, Motor Control]

Parts:
U1: XMC4x00_board_v3; XMC4x00-board_v3-0

Connections:
+3V3: U1.2 (3V3_1), U1.3 (3V3_2), U1.17 (3V3_4), U1.27 (VBAT), U1.29 (3V3_5), U1.39 (3V3_6), U1.42 (3V3_7), U1.59 (3V3_8), U1.62 (3V3_9), U1.79 (3V3_10); also elsewhere on the board
<root sheet>EN: U1.51 (P0.7); also elsewhere on the board
<root sheet>ENC_A: U1.72 (P1.3); also elsewhere on the board
<root sheet>ENC_B: U1.73 (P1.2); also elsewhere on the board
<root sheet>LEM_standby: U1.54 (P0.9); also elsewhere on the board
<root sheet>MAGDEC: U1.53 (P0.10); also elsewhere on the board
<root sheet>MAGINC: U1.52 (P0.8); also elsewhere on the board
<root sheet>VDDA: U1.22 (VDDA); also elsewhere on the board
<root sheet>current_u_amp: U1.34 (P14.4); also elsewhere on the board
<root sheet>current_v_amp: U1.33 (P14.3); also elsewhere on the board
<root sheet>rotary_CLK: U1.74 (P1.1); also elsewhere on the board
<root sheet>rotary_CSn: U1.75 (P1.0); also elsewhere on the board
<root sheet>rotary_DI: U1.68 (CAN0-L_or_P1.5|CAN0_Rx); also elsewhere on the board
<root sheet>rotary_PDIO: U1.69 (CAN0-H_or_P1.4|CAN0_Tx); also elsewhere on the board
<root sheet>u_high_1: U1.46 (P0.3); also elsewhere on the board
<root sheet>u_low_1: U1.43 (P0.0); also elsewhere on the board
<root sheet>v_high: U1.48 (P0.5); also elsewhere on the board
<root sheet>v_low: U1.45 (P0.2); also elsewhere on the board
<root sheet>voltage_u: U1.35 (P14.5); also elsewhere on the board
<root sheet>voltage_v: U1.6 (P14.6); also elsewhere on the board
<root sheet>voltage_w: U1.5 (P14.7); also elsewhere on the board
<root sheet>w_high_1: U1.47 (P0.4); also elsewhere on the board
<root sheet>w_low_1: U1.44 (P0.1); also elsewhere on the board
<root sheet>~FAULT: U1.50 (P0.11); also elsewhere on the board
GND: U1.1 (GND_1), U1.9 (GND_2), U1.10 (GND_3), U1.18 (GND_4), U1.21 (GND_5), U1.23 (GND_6), U1.26 (GND_7), U1.28 (GND_8), U1.30 (GND_9), U1.31 (GND_10), U1.36 (GND_11), U1.40 (GND_12), U1.41 (GND_13), U1.60 (GND_14), U1.61 (GND_15), U1.70 (GND_16), U1.71 (GND_17), U1.80 (GND_18); also elsewhere on the board
unnamed 58: U1.11 (P2.9); also elsewhere on the board
unnamed 59: U1.12 (P2.8); also elsewhere on the board
unnamed 60: U1.13 (P2.5); also elsewhere on the board
unnamed 61: U1.14 (P2.4); also elsewhere on the board
unnamed 62: U1.15 (P2.3); also elsewhere on the board
unnamed 63: U1.16 (P2.2); also elsewhere on the board

Notes on the sheet:
don't solder in CAN0 driver use solder jumper to connect directly to board

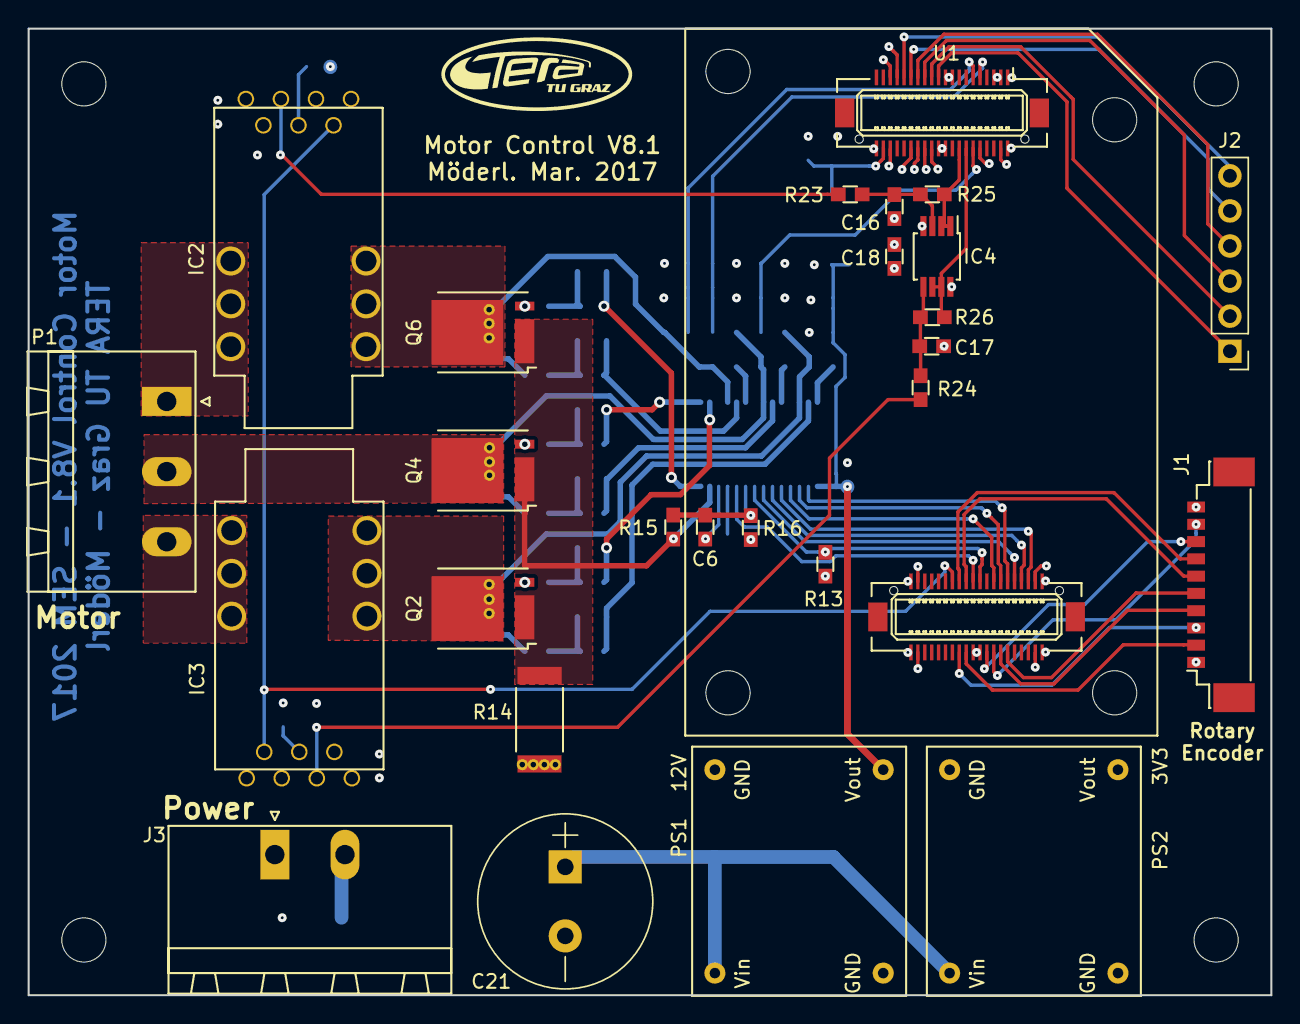
[picture p19: board HW/pcbs/motor/V8/Motor-Control-board-V8_1_KiCAD/Motor_Control.kicad_p… from above]

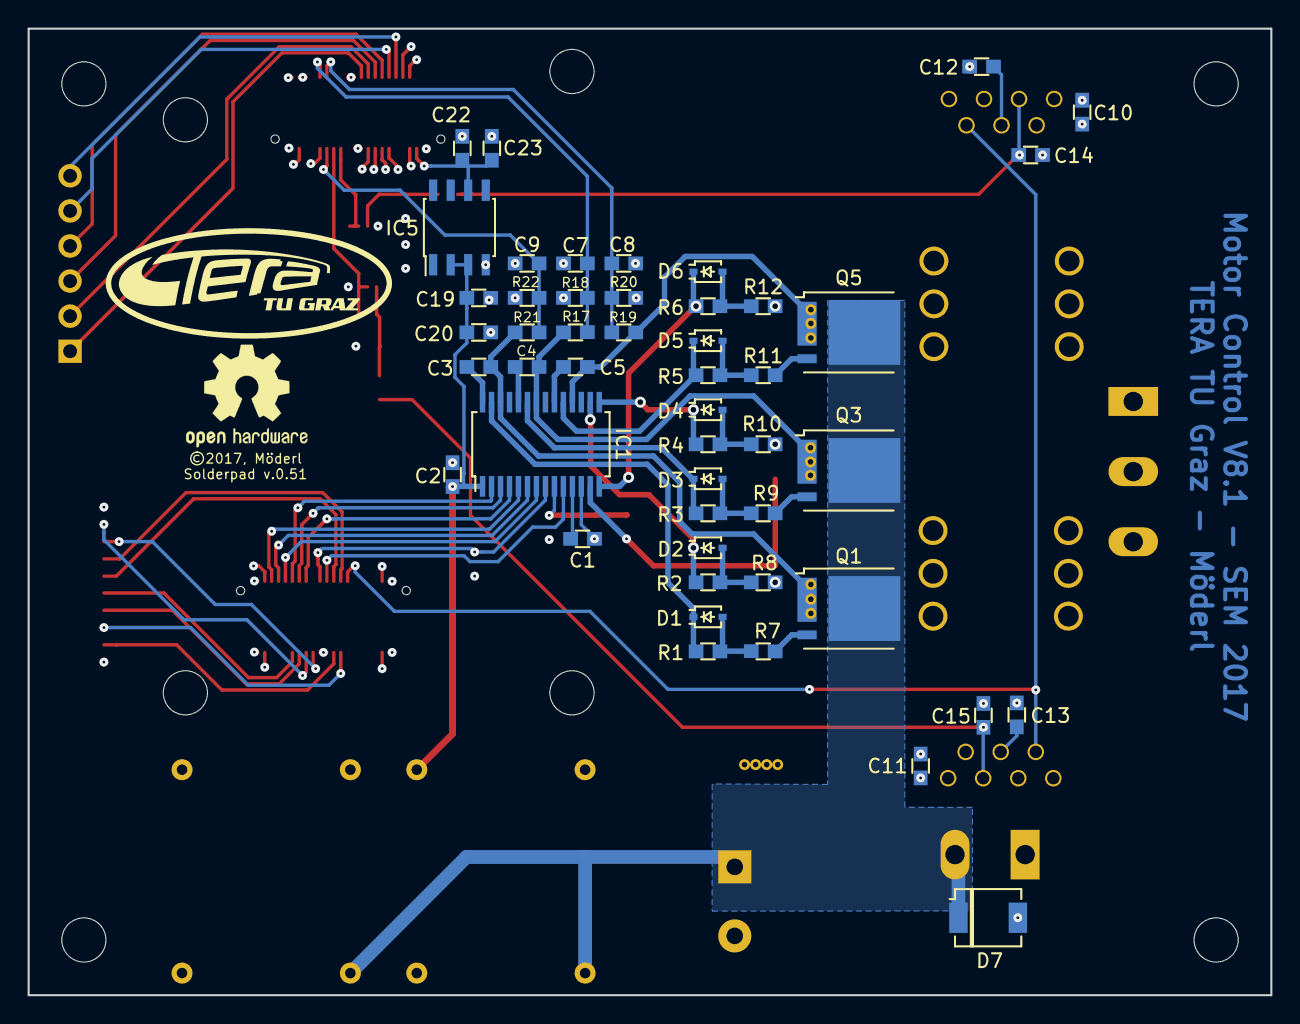
[picture p20: board HW/pcbs/motor/V8/Motor-Control-board-V8_1_KiCAD/Motor_Control.kicad_p… from below]

Board: 4 copper layers, 90.0 x 70.0 mm, 89 parts (56 on the bottom side), 68 nets.

Other parts of the board:
svg2mod: G***; TERA_Logo_SilkS_7.5x19mm
svg2mod#2: G***; TERA_Logo_SilkS_5x12.5mm
