TERA-TU-Graz/fennek_2019/HW/pcbs/BMS/power_distribution/fennek_power_distribution_v1.1/fennek_power_distribution.kicad_pcb

## KiCad design HW/pcbs/BMS/power_distribution/fennek_power_distribution_v1.1/fennek_power_distribution.kicad_pcb (2020-02-26, an earlier design)

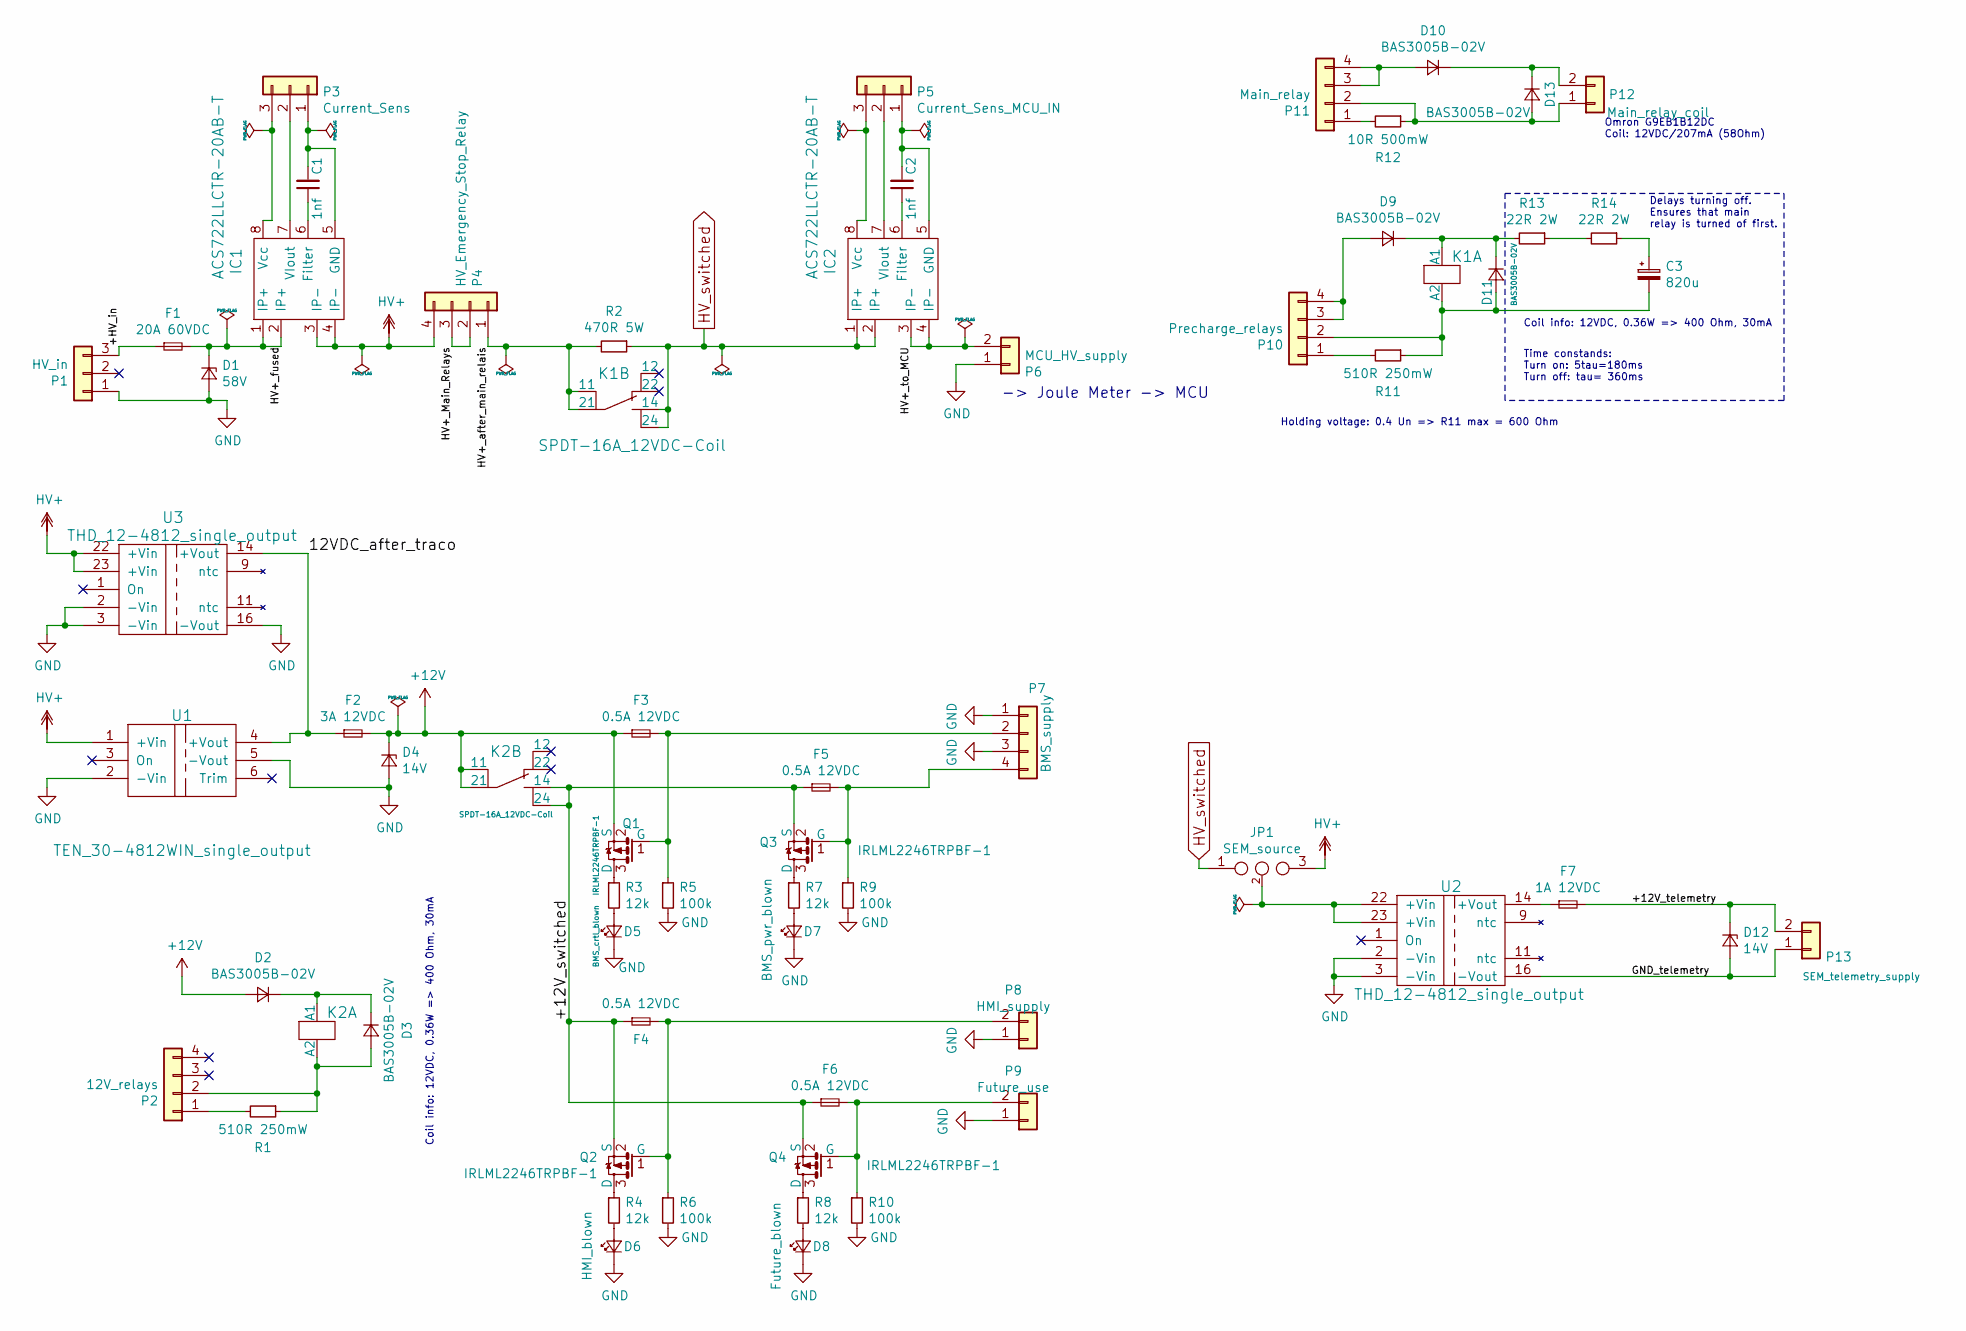
[picture p21: schematic fennek_power_distribution.sch, Power distribution unit Fennek 2017]

Parts:
C1, C2: 1nf; C_0603in
C3: 820u; c_elec_10x10mm
D1: 58V; DO-214AA_with_vias_in_pad
D2, D3, D9, D10, D11, D13: BAS3005B-02V; BAS3005B-02V__sc79
D4, D12: 14V; SOD128_with_vias_in_pad
D5: BMS_crtl_blown; LED_0805
D6: HMI_blown; LED_0805
D7: BMS_pwr_blown; LED_0805
D8: Future_blown; LED_0805
F1: 20A 60VDC; Fuse_holder_6.3x32mm_Schruter_0031.2520
F2: 3A 12VDC; Fuse_Phoenix_SI-H-FKS_15
F3, F4, F5, F6: 0.5A 12VDC; Fuse_0603in
F7: 1A 12VDC; Fuse_Phoenix_SI-H-FKS_15
IC1, IC2: ACS722LLCTR-20AB-T; ACS7xx
JP1: SEM_source; SOLDERJUMPER_3
K1, K2: SPDT-16A_12VDC-Coil; Finder-41.61.9.012.0010_SPDT-16A_12VDC-Coil
P1: HV_in; PhoenixContact_MSTBA-G_03x5.08mm_Angled
P2: 12V_relays; JST_EH_B04B-EH-A_04x2.50mm_Straight
P3: Current_Sens; Molex_PicoBlade_53398-0371_03x1.25mm_Straight
P4: HV_Emergency_Stop_Relay; PhoenixContact_MSTBA-G_04x5.08mm_Angled
P5: Current_Sens_MCU_IN; Molex_PicoBlade_53398-0371_03x1.25mm_Straight
P6: MCU_HV_supply; PhoenixContact_MSTB-GF_02x5.08mm_Angled_ThreadedFlange
P7: BMS_supply; JST_XH_B04B-XH-A_04x2.50mm_Straight
P8: HMI_supply; JST_XH_B02B-XH-A_02x2.50mm_Straight
P9: Future_use; JST_XH_B02B-XH-A_02x2.50mm_Straight
P10: Precharge_relays; JST_EH_B04B-EH-A_04x2.50mm_Straight
P11: Main_relay; JST_EH_B04B-EH-A_04x2.50mm_Straight
P12: Main_relay_coil; JST_EH_B02B-EH-A_02x2.50mm_Straight
P13: SEM_telemetry_supply; PhoenixContact_MC-GF_02x3.50mm_Angled_ThreadedFlange
Q1, Q2, Q3, Q4: IRLML2246TRPBF-1
R1, R11: 510R 250mW; R_1206in
R2: 470R 5W; TE_SMW-5W
R3, R4, R7, R8: 12k; R_0603in
R5, R6, R9, R10: 100k; R_0603in
R12: 10R 500mW; R_1210in
R13, R14: 22R 2W; R_2512in
U1: TEN_30-4812WIN_single_output; TEN_30-xxxx
U2, U3: THD_12-4812_single_output; THD_12-xxxx

Connections:
+12V: D2.2 (A), D4.1 (K), F2.2, F3.1, K2.5 (11), K2.6 (21), Q1.2 (S)
/12VDC_after_traco: F2.1, U1.4 (+Vout), U3.14 (+Vout)
/+12V_switched: F4.1, F5.1, F6.1, K2.7 (14), K2.8 (24), Q2.2 (S), Q3.2 (S), Q4.2 (S)
/+12V_telemetry: D12.1 (K), F7.2, P13.2
/+HV_in: F1.1, P1.3
/GND_telemetry: D12.2 (A), P13.1, U2.16 (-Vout)
/HV+_Main_Relays: P4.2, P4.3
/HV+_after_main_relais: K1.5 (11), K1.6 (21), P4.1, R2.2
/HV+_fused: D1.1 (K), F1.2, IC1.1 (IP+), IC1.2 (IP+)
/HV+_to_MCU: IC2.3 (IP-), IC2.4 (IP-), P6.2
GND: D1.2 (A), D4.2 (A), D5.1 (K), D6.1 (K), D7.1 (K), D8.1 (K), P1.1, P6.1, P7.1, P7.3, P8.1, P9.1, R5.2, R6.2, R9.2, R10.2, U1.2 (-Vin), U1.5 (-Vout), U2.2 (-Vin), U2.3 (-Vin), U3.2 (-Vin), U3.3 (-Vin), U3.16 (-Vout)
HV+: IC1.3 (IP-), IC1.4 (IP-), JP1.3, P4.4, U1.1 (+Vin), U3.22 (+Vin), U3.23 (+Vin)
HV_switched: IC2.1 (IP+), IC2.2 (IP+), JP1.1 (m), K1.7 (14), K1.8 (24), R2.1
unnamed: C1.1, IC1.6 (Filter)
unnamed: C1.2, IC1.5 (GND), P3.1
unnamed: C2.1, IC2.6 (Filter)
unnamed: C2.2, IC2.5 (GND), P5.1
unnamed: C3.1, R14.1
unnamed: C3.2, D11.2 (A), K1.2 (A2), P10.2, R11.1
unnamed: D2.1 (K), D3.1 (K), K2.1 (A1)
unnamed: D3.2 (A), K2.2 (A2), P2.2, R1.1
unnamed: D5.2 (A), R3.2
unnamed: D6.2 (A), R4.2
unnamed: D7.2 (A), R7.2
unnamed: D8.2 (A), R8.2
unnamed: D9.2 (A), P10.3, P10.4
unnamed: D10.1 (K), D13.1 (K), P12.2
unnamed: D10.2 (A), P11.3, P11.4
unnamed: D9.1 (K), D11.1 (K), K1.1 (A1), R13.2
unnamed: D13.2 (A), P11.2, P12.1, R12.1
unnamed: F3.2, P7.2, Q1.1 (G), R5.1
unnamed: F4.2, P8.2, Q2.1 (G), R6.1
unnamed: F5.2, P7.4, Q3.1 (G), R9.1
unnamed: F6.2, P9.2, Q4.1 (G), R10.1
unnamed: F7.1, U2.14 (+Vout)
unnamed: IC1.7 (VIout), P3.2
unnamed: IC1.8 (Vcc), P3.3
unnamed: IC2.7 (VIout), P5.2
unnamed: IC2.8 (Vcc), P5.3
unnamed: JP1.2, U2.22 (+Vin), U2.23 (+Vin)
unnamed: P2.1, R1.2
unnamed: P10.1, R11.2
unnamed: P11.1, R12.2
unnamed: Q1.3 (D), R3.1
unnamed: Q2.3 (D), R4.1
unnamed: Q3.3 (D), R7.1
unnamed: Q4.3 (D), R8.1
unnamed: R13.1, R14.2

Notes on the sheet:
Delays turning off. Ensures that main relay is turned of first.
Omron G9EB1B12DC Coil: 12VDC/207mA (58Ohm)
Coil info: 12VDC, 0.36W => 400 Ohm, 30mA
Time constands: Turn on: 5tau=180ms Turn off: tau= 360ms
-> Joule Meter -> MCU
Holding voltage: 0.4 Un => R11 max = 600 Ohm

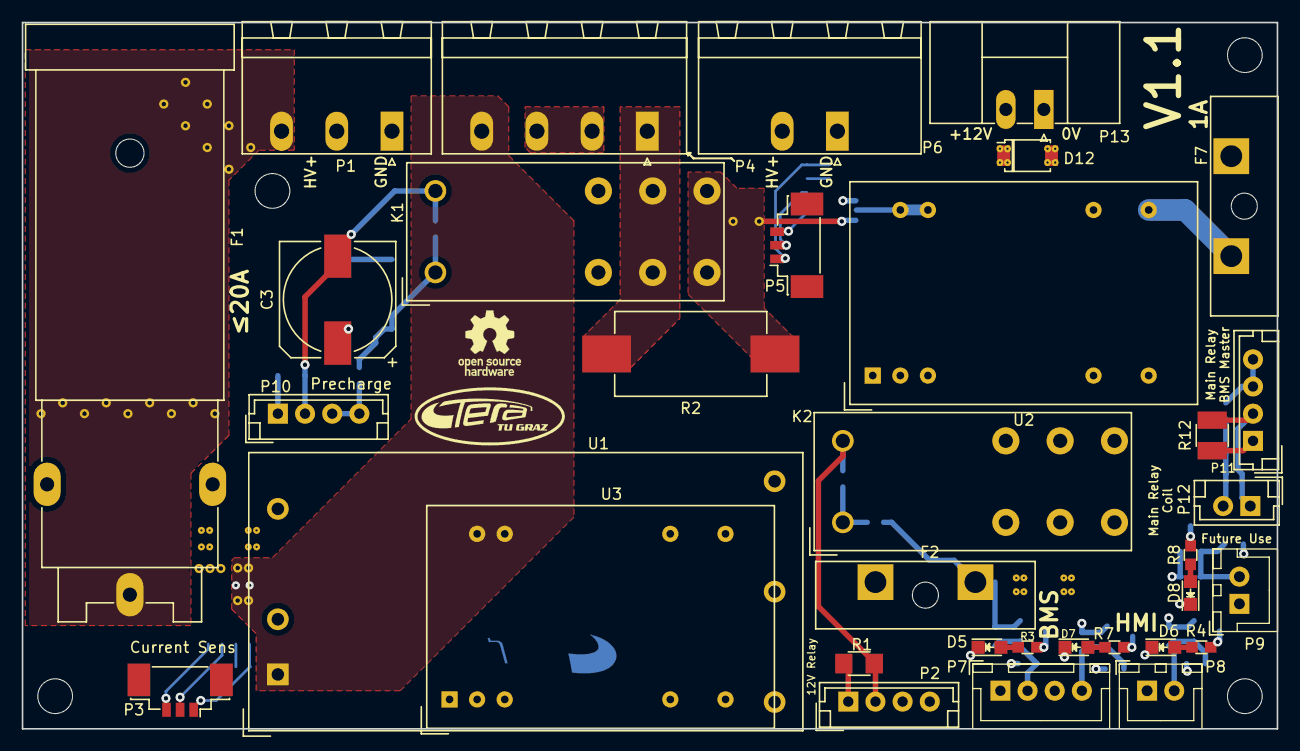
[picture p22: board HW/pcbs/BMS/power_distribution/fennek_power_distribution_v1.1/fennek_… from above]

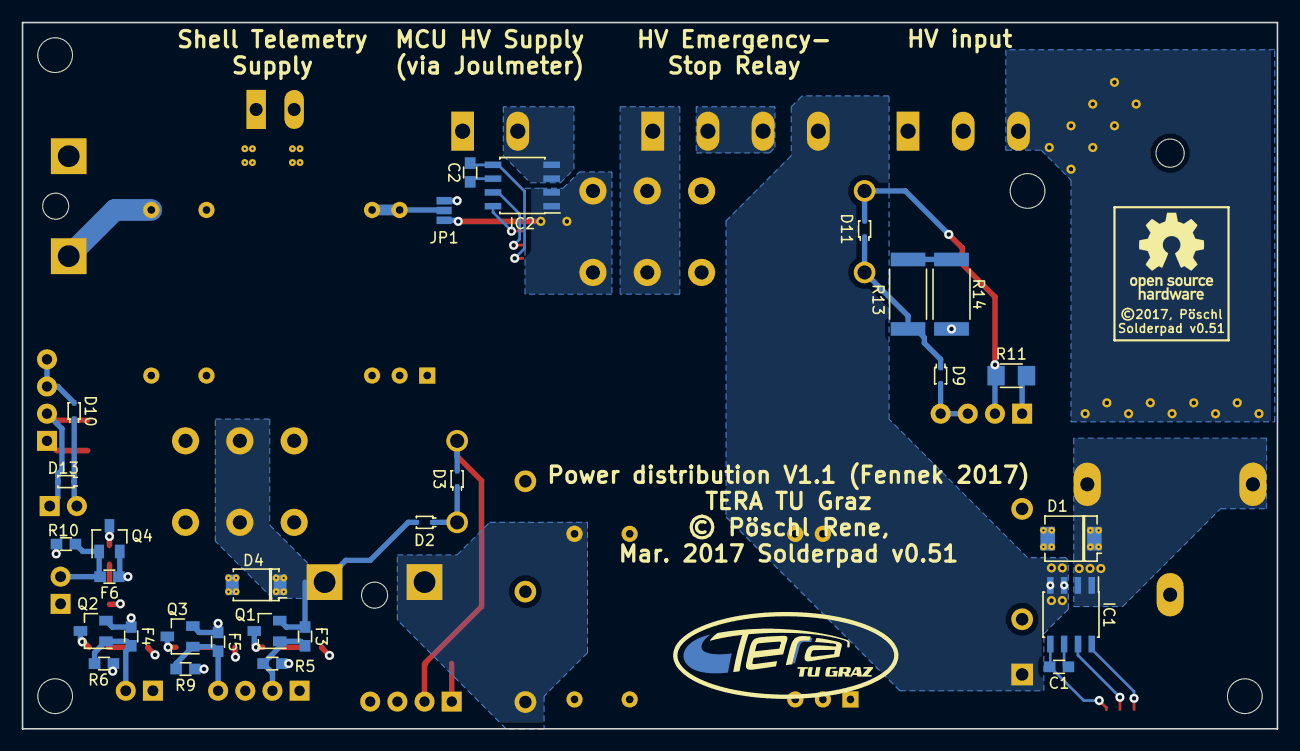
[picture p23: board HW/pcbs/BMS/power_distribution/fennek_power_distribution_v1.1/fennek_… from below]

Board: 4 copper layers, 115.5 x 65.0 mm, 64 parts (29 on the bottom side), 48 nets.

Other parts of the board:
svg2mod: G***; TERA_Logo_SilkS_5x12.5mm
svg2mod#2: G***; TERA_Logo_SilkS_and_Cu_7.5x19mm
