TERA-TU-Graz/fennek_2019/HW/pcbs/BMS/Interlock/Interlock_RelayInterface_v1/Interlock.kicad_pcb

## KiCad design HW/pcbs/BMS/Interlock/Interlock_RelayInterface_v1/Interlock.kicad_pcb (2020-02-26)

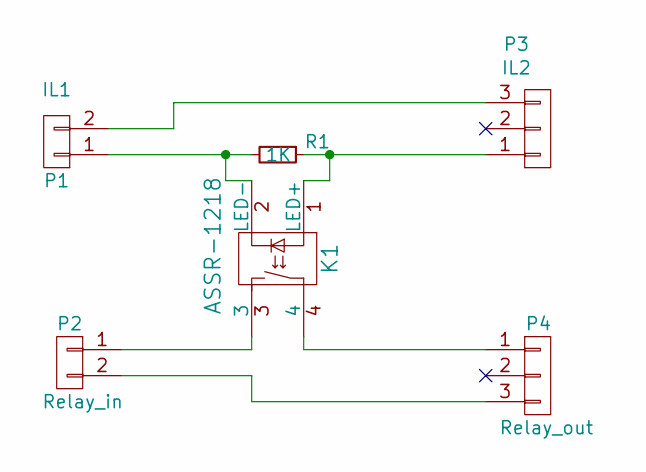
[picture p24: schematic Interlock.sch, BMS fennek interlock relay interface]

Parts:
K1: ASSR-1218; SO-4
P1: IL1; JST_EH_B02B-EH-A_02x2.50mm_Straight
P2: Relay_in; JST_XH_B02B-XH-A_02x2.50mm_Straight
P3: IL2; JST_EH_S03B-EH_03x2.50mm_Angled
P4: Relay_out; JST_XH_S03B-XH-A_03x2.50mm_Angled
R1: 1K; R_0603in

Connections:
unnamed: K1.1 (LED+), P3.1, R1.1
unnamed: K1.2 (LED-), P1.1, R1.2
unnamed: K1.3, P2.1
unnamed: K1.4, P4.1
unnamed: P1.2, P3.3
unnamed: P2.2, P4.3

Board: 2 copper layers, 6 parts (0 on the bottom side), 6 nets, no tracks yet.
