TERA-TU-Graz/fennek_2019/HW/pcbs/other/horn_dc-dc/horn_dc-dc.kicad_pcb

## KiCad design HW/pcbs/other/horn_dc-dc/horn_dc-dc.kicad_pcb (2020-02-26)

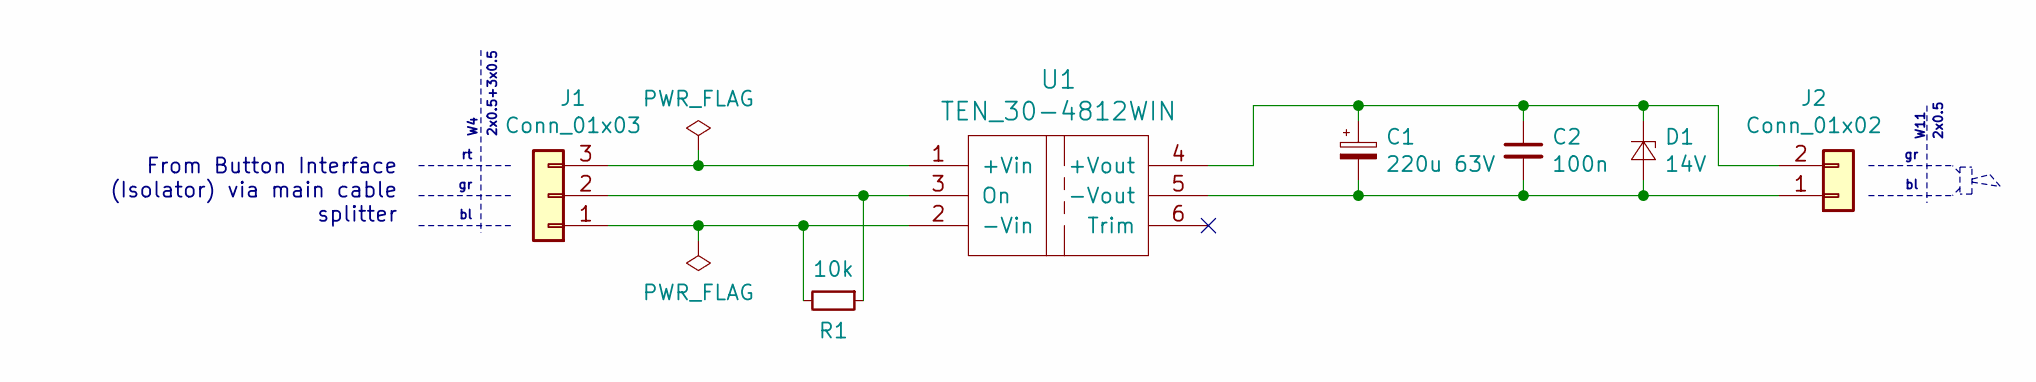
[picture p25: schematic horn_dc-dc.sch, DC/DC Horn]

Parts:
C1: 220u 63V; c_elec_10x10mm
C2: 100n; C_0603in
D1: 14V; SOD128
J1: Conn_01x03; JST_XH_B03B-XH-A_03x2.50mm_Straight
J2: Conn_01x02; JST_EH_B02B-EH-A_02x2.50mm_Straight
R1: 10k; R_0603in
U1: TEN_30-4812WIN; TEN_30-xxxx

Connections:
unnamed: C1.1, C2.1, D1.1 (K), J2.2, U1.4 (+Vout)
unnamed: C1.2, C2.2, D1.2 (A), J2.1, U1.5 (-Vout)
unnamed: J1.1, R1.2, U1.2 (-Vin)
unnamed: J1.2, R1.1, U1.3 (On)
unnamed: J1.3, U1.1 (+Vin)

Notes on the sheet:
2x0.5+3x0.5
From Button Interface (Isolator) via main cable splitter
2x0.5
W11

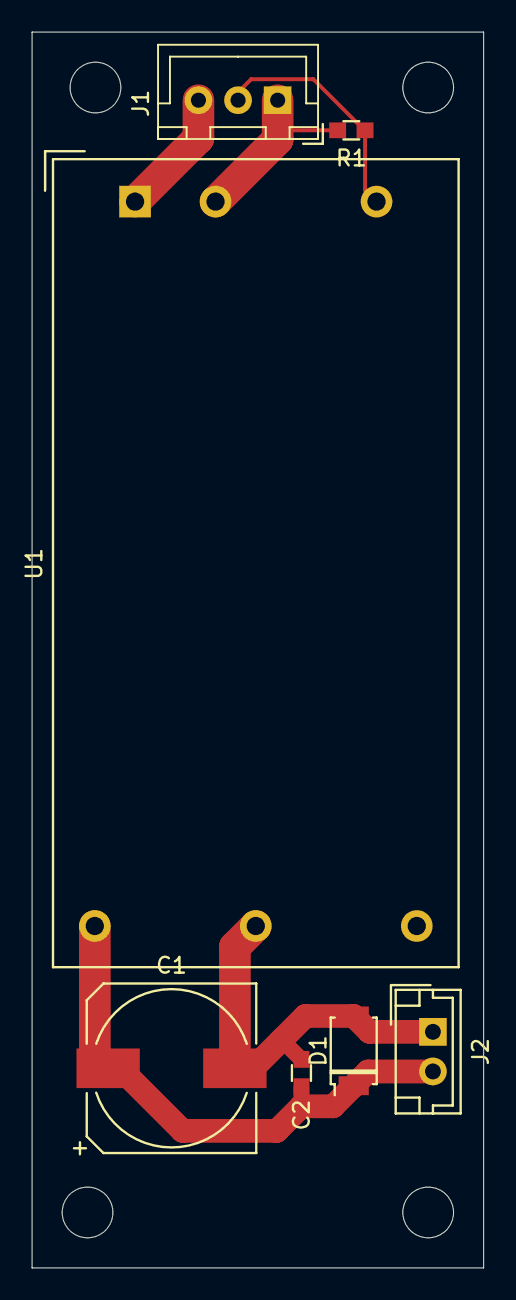
[picture p26: board horn_dc-dc.kicad_pcb from above]

Board: 2 copper layers, 28.5 x 78.0 mm, 7 parts (0 on the bottom side), 5 nets.
