TERA-TU-Graz/fennek_2019/HW/pcbs/BMS/power_distribution/fennek_power_distribution_v2/fennek_power_distribution.kicad_pcb

## KiCad design HW/pcbs/BMS/power_distribution/fennek_power_distribution_v2/fennek_power_distribution.kicad_pcb (2020-02-26)

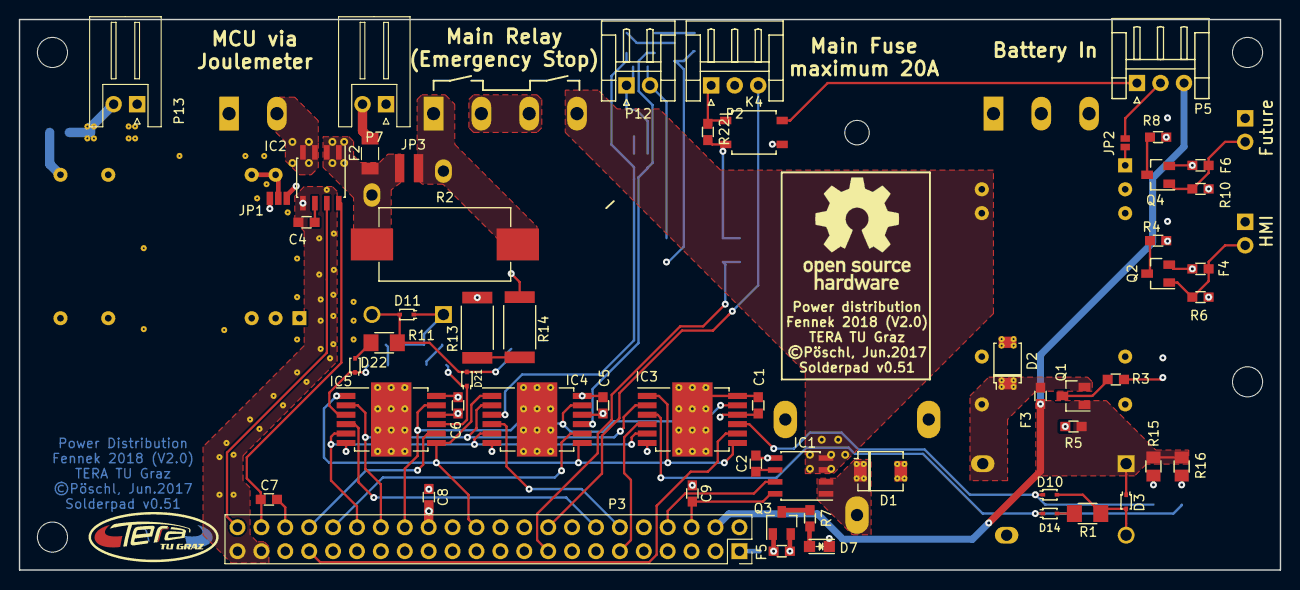
[picture p27: board HW/pcbs/BMS/power_distribution/fennek_power_distribution_v2/fennek_po… from above]

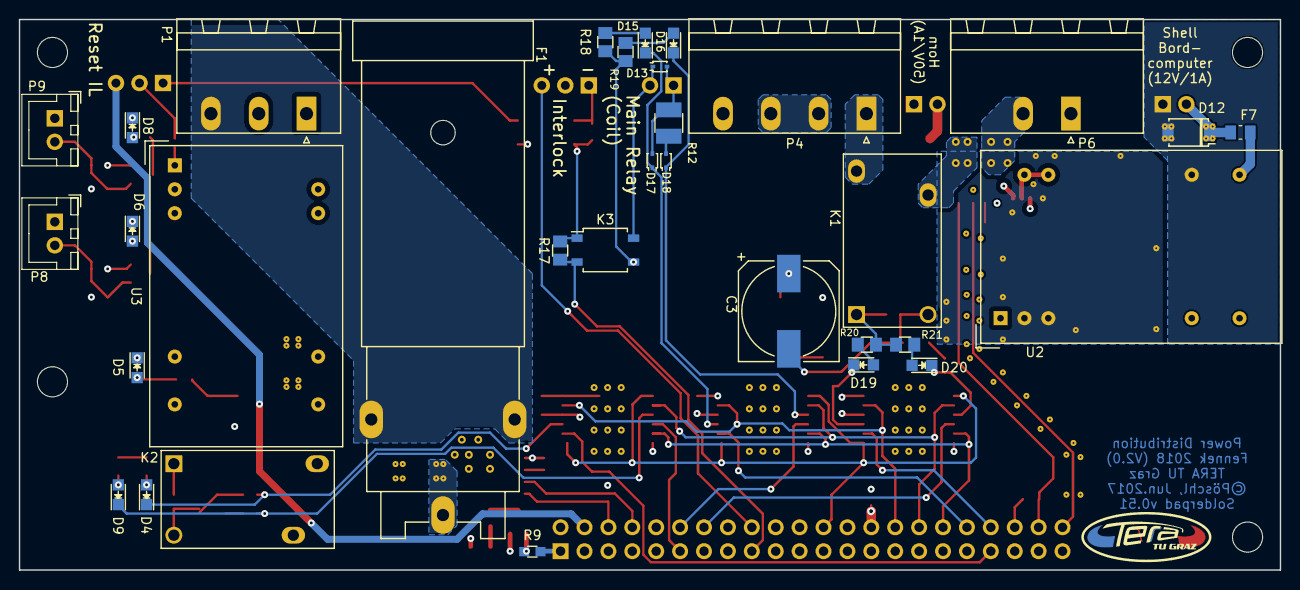
[picture p28: board HW/pcbs/BMS/power_distribution/fennek_power_distribution_v2/fennek_po… from below]

Board: 4 copper layers, 134.0 x 58.5 mm, 91 parts (34 on the bottom side), 71 nets.

Parts:
C1, C5, C6, C7, C8, C9: 100n; C_0603in
C2, C4: 1nf; C_0603in
C3: 820u; c_elec_10x10mm
D1: 58V; DO-214AA_with_vias_in_pad
D2, D12: 14V; SOD128_with_vias_in_pad
D3, D10, D11, D13, D14, D17, D18, D21, D22: BAS3005B-02V; BAS3005B-02V__sc79
D4, D15, D19: K_CH1; LED_0805
D5: BMS_crtl_blown; LED_0805
D6: HMI_blown; LED_0805
D7: BMS_pwr_blown; LED_0805
D8: Future_blown; LED_0805
D9, D16, D20: K_CH2; LED_0805
F1: 20A 60VDC; Fuse_holder_6.3x32mm_Schruter_0031.2520
F2: 1A 63VDC; Fuse_1206_3216Metric_Pad1.24x1.80mm_HandSolder
F3, F4, F5, F6: 0.5A 12VDC; Fuse_0603in
F7: 1A 12VDC; Fuse_0805_2012Metric_Pad1.15x1.50mm_HandSolder
IC1, IC2: ACS722LLCTR-20AB-T; ACS7xx
IC3, IC4, IC5: TLE8102SG; INF-PG-DSO-12-11-EP_N_EPvias
JP1: SEM_source; SOLDERJUMPER_3
JP2: Jumper_NO_Small; SOLDERJUMPER_2_1mm
JP3: Jumper_NO_Small; SOLDERJUMPER_2_3mm_HV
K1, K2: TE_OJ-SH-112DM; RELAIS-TE-OJ
K3: ASSR-1218; SO-4
K4: Panasonic_AQY414S; SO-4
P1: HV_in; PhoenixContact_MSTBA-G_03x5.08mm_Angled
P2: Interlock; JST_EH_S03B-EH_03x2.50mm_Angled
P3: CONN_02X22; ESW-122-12-L-D
P4: HV_Emergency_Stop_Relay; PhoenixContact_MSTBA-G_04x5.08mm_Angled
P5: Reset_Interlock; JST_EH_S03B-EH_03x2.50mm_Angled
P6: MCU_HV_supply; PhoenixContact_MSTB-GF_02x5.08mm_Angled_ThreadedFlange
P7: Horn; JST_XH_S02B-XH-A_02x2.50mm_Angled
P8: HMI_supply; JST_XH_B02B-XH-A_02x2.50mm_Straight
P9: Future_use; JST_XH_B02B-XH-A_02x2.50mm_Straight
P12: Main_relay_coil; JST_EH_S02B-EH_02x2.50mm_Angled
P13: SEM_telemetry_supply; JST_XH_S02B-XH-A_02x2.50mm_Angled
Q1, Q2, Q3, Q4: IRLML2246TRPBF-1
R1, R11: 180R; R_1206in
R2: 470R 5W; TE_SMW-5W
R3, R4, R7, R8: 12k; R_0603in
R5, R6, R9, R10: 100k; R_0603in
R12: 10R 500mW; R_1210in
R13, R14: 22R 2W; R_2512in
R15, R16, R18, R19, R20, R21: 12k; R_0805in
R17: 1k; R_0805in
R22: 1k; R_0603in
U2, U3: THD_12-4812_single_output; THD_12-xxxx
svg2mod, svg2mod#2: G***; TERA_Logo_SilkS_and_Cu_5x12.5mm

Connections:
/12VDC Bordnet/12V_Relay_Fault: IC3.4, P3.11
/12VDC Bordnet/+5V: C1.2, C5.2, C6.2, C8.2, IC3.10, IC4.10, IC5.10, P3.28
/12VDC Bordnet/+12VDC: D2.1, F3.1, K2.11, Q1.2, U3.14
/12VDC Bordnet/+12V_Future: F6.2, P9.2, Q4.1, R10.1
/12VDC Bordnet/+12V_HMI: F4.2, P8.2, Q2.1, R6.1
/12VDC Bordnet/+12V_switched: F4.1, F5.1, F6.1, K2.14, Q2.2, Q3.2, Q4.2
/12VDC Bordnet/BN_IL: K4.4, P5.1
/12VDC Bordnet/BN_on: JP2.1, P5.2
/12VDC Bordnet/IL_next-: K4.1, P2.1, R22.1
/12VDC Bordnet/Interlock_OK: IC3.1, IC3.7, IC4.1, IC4.7, IC5.1, IC5.7, P3.24
/12VDC Bordnet/LowSideSwitch_12V_Relay/CHANNEL1: D3.2, D10.2, K2.A2, R1.1
/12VDC Bordnet/LowSideSwitch_12V_Relay/CHANNEL2: D14.2, R1.2
/12VDC Bordnet/MISO: IC3.11, IC4.11, IC5.11, P3.30
/12VDC Bordnet/MOSI: IC3.2, IC4.2, IC5.2, P3.32
/12VDC Bordnet/NCS_12V_Relay: IC3.8, P3.37
/12VDC Bordnet/SCLK: IC3.5, IC4.5, IC5.5, P3.34
/12VDC telemetry/+12V_telemetry: D12.1, F7.2, P13.2
/12VDC telemetry/GND_telemetry: D12.2, P13.1, U2.16
/High voltage/+3V3: C7.2, C9.2, IC1.8, IC2.8, P3.6, P3.42
/High voltage/+HV_in: F1.2, P1.3
/High voltage/+VBatt: IC1.3, IC1.4, JP1.3, P4.4, U3.22, U3.23
/High voltage/HV+_Main_Relays: P4.2, P4.3
/High voltage/HV+_after_main_relais: JP3.1, K1.11, P4.1, R2.2
/High voltage/HV+_fused: D1.1, F1.1, IC1.1, IC1.2
/High voltage/HV+_to_MCU: IC2.3, IC2.4, P6.2
/High voltage/IL_next-: K3.1, K4.2, R17.2, R22.2
/High voltage/ISense_MCU: IC2.7, P3.44
/High voltage/ISense_Main: IC1.7, P3.8
/High voltage/LowSideSwitch_MainRelay/CHANNEL2: D18.2, R12.2
/High voltage/LowSideSwitch_PreCharge/CHANNEL2: D22.2, R11.2
/High voltage/MainRelay_Fault: IC4.4, P3.12
/High voltage/Main_Relay_A1: D13.1, K3.4, P12.2
/High voltage/Main_Relay_A2: D13.2, D17.2, P12.1, R12.1
/High voltage/NCS_MainRelay: IC4.8, P3.36
/High voltage/PreCharge_Fault: IC5.4, P3.14
/High voltage/PreCharger_A2: C3.2, D11.2, D21.2, K1.A2, R11.1
/High voltage/V+_Horn: F2.2, P7.2
/High voltage/VBatt_Switched: F2.1, IC2.1, IC2.2, JP1.1, JP3.2, K1.14, R2.1
/Master Connector/+12VDC_BMS: D3.1, F3.2, K2.A1, P3.4, P5.3, Q1.1, R5.1, R15.1, R16.1
/Master Connector/+12VDC_BMS_Switched: D11.1, F5.2, K1.A1, K3.3, P3.2, Q3.1, R9.1, R13.2, R18.1, R19.1, R20.1, R21.1
/Master Connector/IL_master+: P2.3, P3.18
/Master Connector/IL_master-: K3.2, P3.17, R17.1
/Master Connector/NCS_PreCharge: IC5.8, P3.38
GND: C1.1, C2.2, C4.2, C5.1, C6.1, C7.1, C8.1, C9.1, D1.2, D2.2, D5.1, D6.1, D7.1, D8.1, IC1.5, IC2.5, IC3.6, IC3.12, IC3.13, IC4.6, IC4.12, IC4.13, IC5.6, IC5.12, IC5.13, K4.3, P1.1, P3.1, P3.3, P3.5, P3.7, P3.9, P3.10, P3.13, P3.21, P3.22, P3.23, P3.25, P3.26, P3.27, P3.29, P3.31, P3.33, P3.35, P3.39, P3.40, P3.41, P3.43, P6.1, P7.1, P8.1, P9.1, R5.2, R6.2, R9.2, R10.2, U2.2, U2.3, U3.2, U3.3, U3.16
unnamed: C2.1, IC1.6
unnamed: C3.1, R14.1
unnamed: C4.1, IC2.6
unnamed: D4.2, R15.2
unnamed: D5.2, R3.2
unnamed: D6.2, R4.2
unnamed: D7.2, R7.2
unnamed: D8.2, R8.2
unnamed: D9.2, R16.2
unnamed: D4.1, D10.1, IC3.9
unnamed: D9.1, D14.1, IC3.3
unnamed: D15.1, D17.1, IC4.9
unnamed: D15.2, R18.2
unnamed: D16.1, D18.1, IC4.3
unnamed: D16.2, R19.2
unnamed: D19.1, D21.1, IC5.9
unnamed: D19.2, R20.2
unnamed: D20.1, D22.1, IC5.3
unnamed: D20.2, R21.2
unnamed: F7.1, U2.14
unnamed: JP1.2, U2.22, U2.23
unnamed: JP2.2, U3.1
unnamed: Q1.3, R3.1
unnamed: Q2.3, R4.1
unnamed: Q3.3, R7.1
unnamed: Q4.3, R8.1
unnamed: R13.1, R14.2
