TERA-TU-Graz/fennek_2019/HW/pcbs/motor/V8/Motor-Control-board-V8_KiCAD/Motor_Control.kicad_pcb

## KiCad design HW/pcbs/motor/V8/Motor-Control-board-V8_KiCAD/Motor_Control.kicad_pcb (2020-02-26, an earlier design)

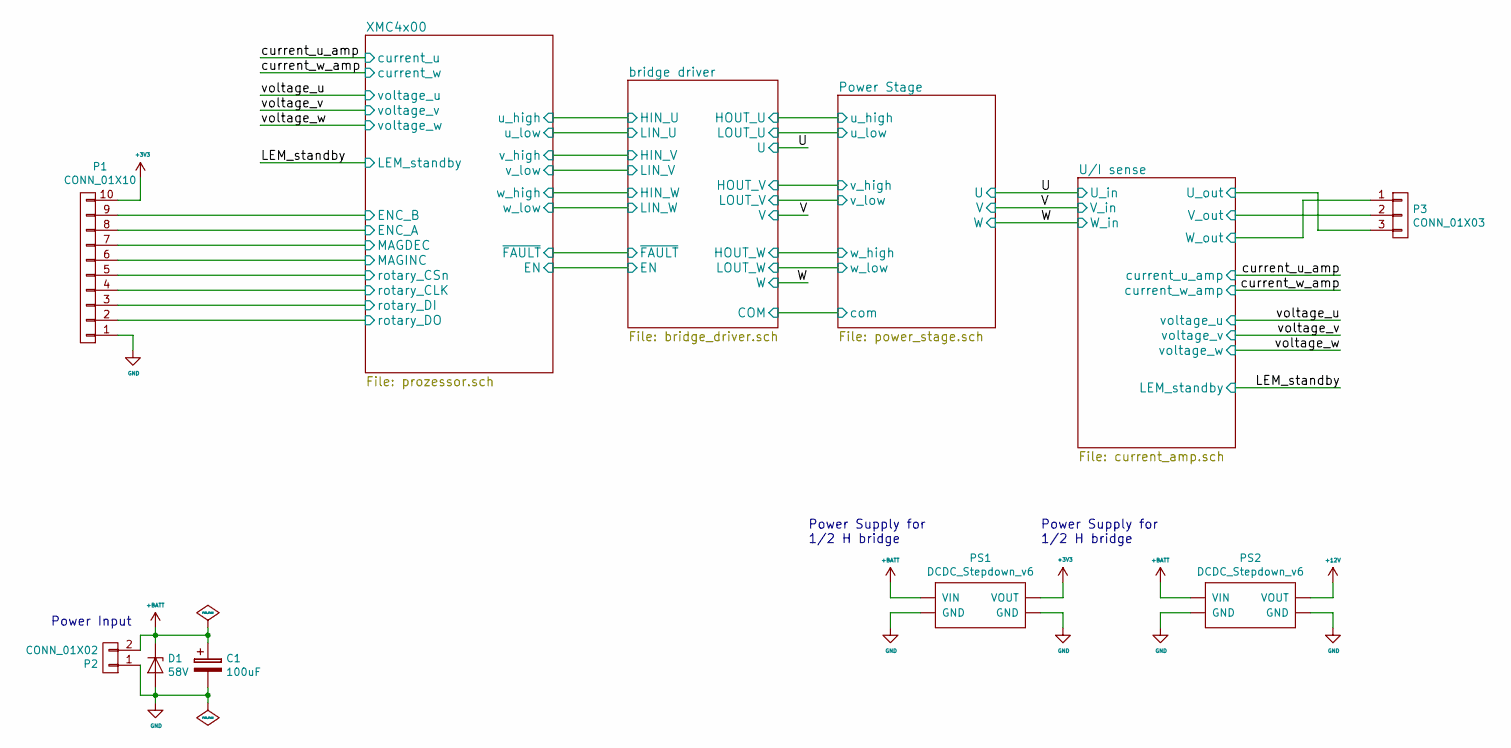
[picture p29: schematic Motor_Control.sch]

Parts:
C1: 100uF; ElkoC-12.5x20mm-horizontal
D1: 58V; DO-214AA
P1: CONN_01X10; Molex_PicoBlade_53261-1071_10x1.25mm_Angled
P2: CONN_01X02; MSTBV_2.5_2-GF-5.08mm
P3: CONN_01X03; PhoenixContact_MSTBA-G_03x5.08mm_Angled
PS1, PS2: DCDC_Stepdown_v6

Connections:
+3V3: P1.10, PS1.2 (VOUT); also elsewhere on the board
+12V: PS2.2 (VOUT); also elsewhere on the board
+BATT: C1.1, D1.1 (K), P2.2, PS1.1 (VIN), PS2.1 (VIN); also elsewhere on the board
/U/I sense/U_out: P3.3; also elsewhere on the board
/U/I sense/W_out: P3.1; also elsewhere on the board
/V: P3.2; also elsewhere on the board
/XMC4x00/ENC_A: P1.8; also elsewhere on the board
/XMC4x00/ENC_B: P1.9; also elsewhere on the board
/XMC4x00/MAGDEC: P1.7; also elsewhere on the board
/XMC4x00/MAGINC: P1.6; also elsewhere on the board
/XMC4x00/rotary_CLK: P1.4; also elsewhere on the board
/XMC4x00/rotary_CSn: P1.5; also elsewhere on the board
/XMC4x00/rotary_DI: P1.3; also elsewhere on the board
/XMC4x00/rotary_DO: P1.2; also elsewhere on the board
GND: C1.2, D1.2 (A), P1.1, P2.1, PS1.3 (GND), PS1.4 (GND), PS2.3 (GND), PS2.4 (GND); also elsewhere on the board

Notes on the sheet:
Power Supply for 1/2 H bridge
Power Input
