TERA-TU-Graz/fennek_2019/HW/pcbs/motor/V8/Motor-Control-board-V8_KiCAD/Motor_Control.kicad_pcb

## KiCad design HW/pcbs/motor/V8/Motor-Control-board-V8_KiCAD/Motor_Control.kicad_pcb (continued)

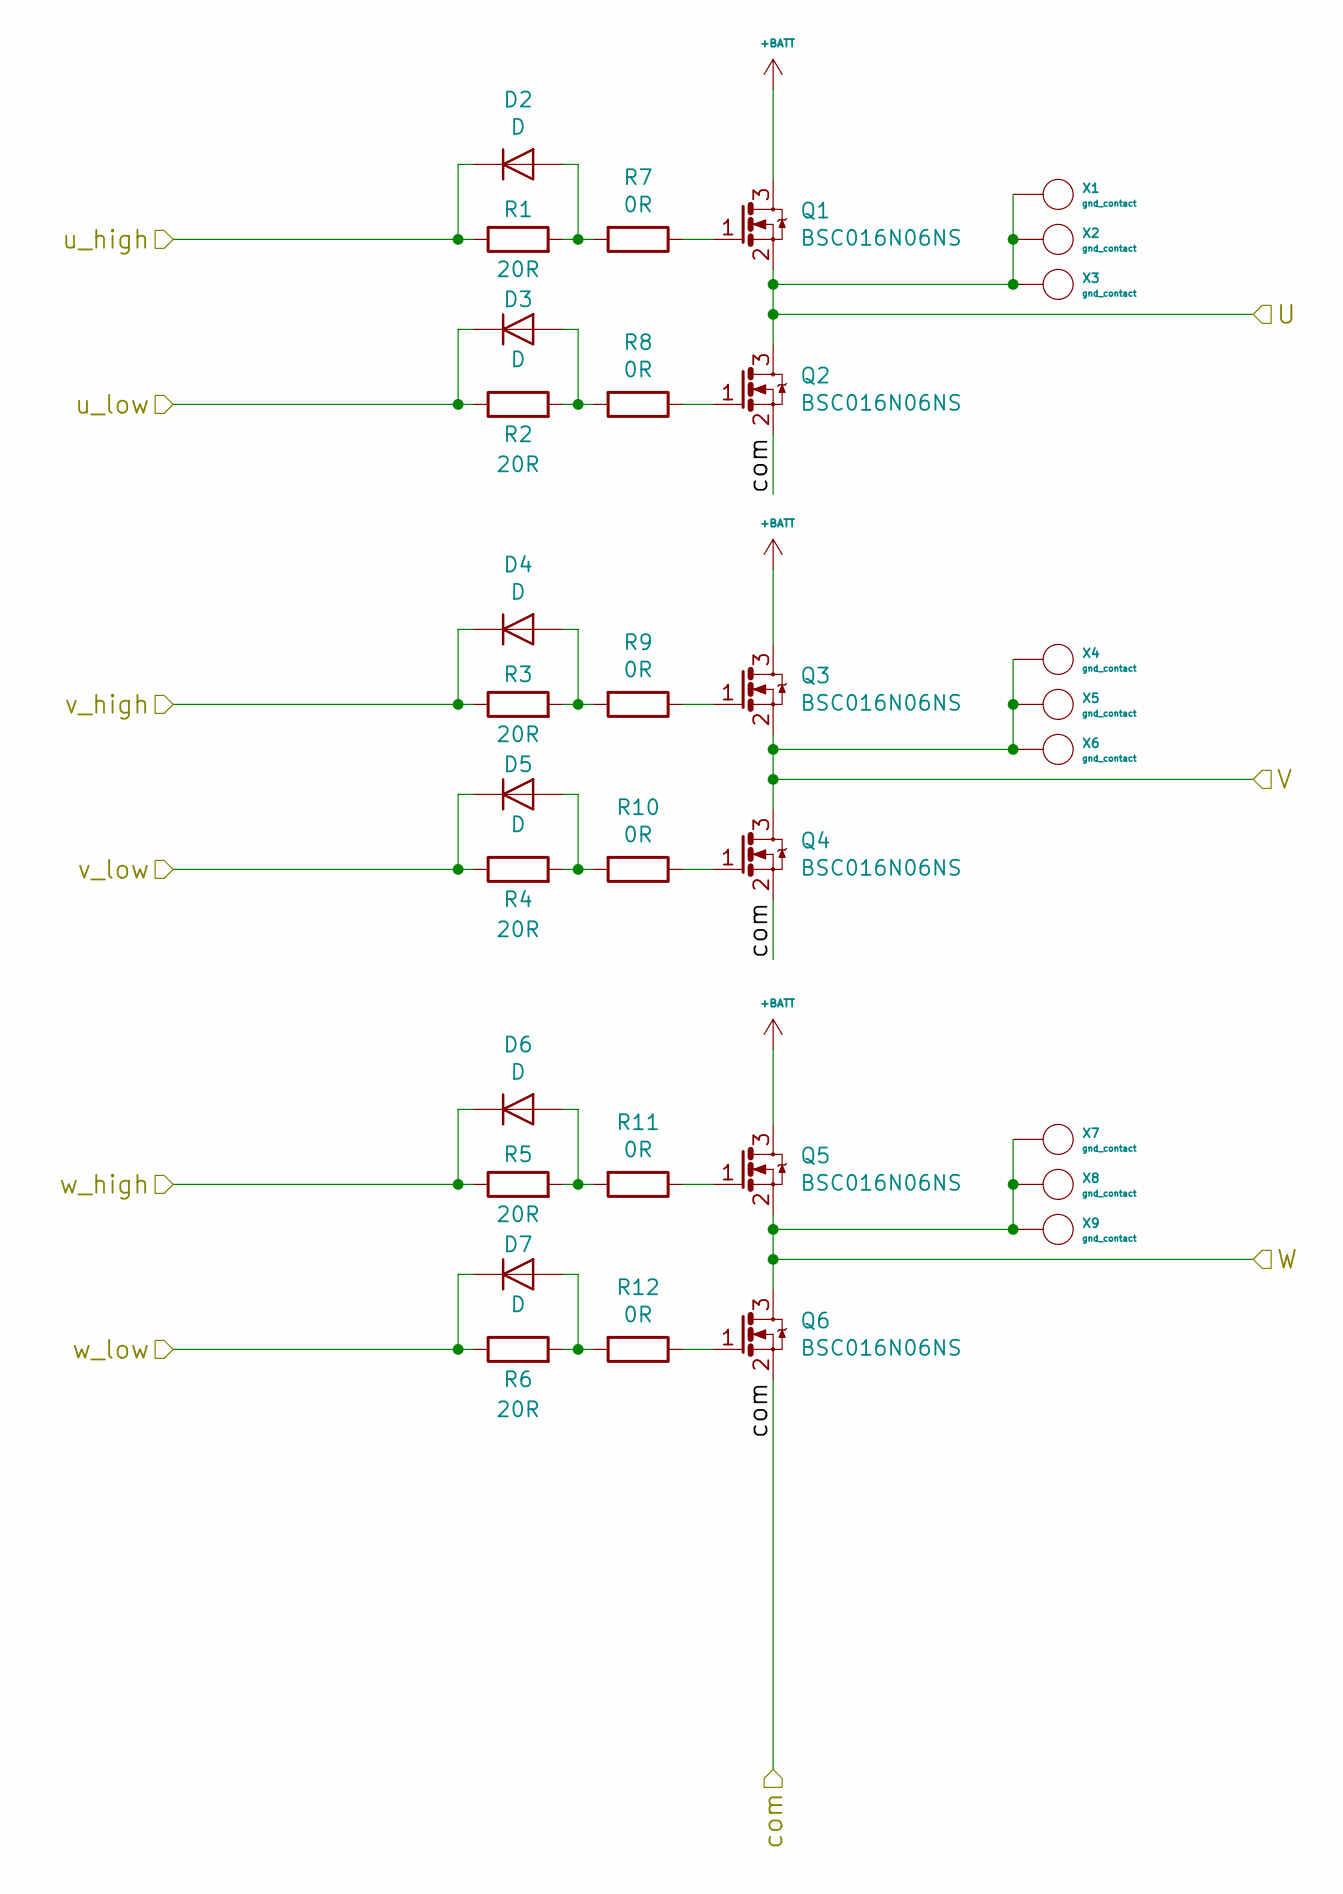
[picture p30: schematic power_stage.sch]

Parts:
D2, D3, D4, D5, D6, D7: D; SOD-323
Q1, Q2, Q3, Q4, Q5, Q6: BSC016N06NS; INF-PG-TDSON-8
R1, R2, R3, R4, R5, R6: 20R; R_0603in
R7, R8, R9, R10, R11, R12: 0R; R_0603in
X1, X2, X3, X4, X5, X6, X7, X8, X9: gnd_contact; via_0.4mm

Connections:
+BATT: Q1.3 (D), Q3.3 (D), Q5.3 (D); also elsewhere on the board
/U: Q1.2 (S), Q2.3 (D), X1.1, X2.1, X3.1; also elsewhere on the board
/V: Q3.2 (S), Q4.3 (D), X4.1, X5.1, X6.1; also elsewhere on the board
/W: Q5.2 (S), Q6.3 (D), X7.1, X8.1, X9.1; also elsewhere on the board
/bridge driver/COM: Q2.2 (S), Q4.2 (S), Q6.2 (S); also elsewhere on the board
/bridge driver/HOUT_U: D2.1 (K), R1.1; also elsewhere on the board
/bridge driver/HOUT_V: D4.1 (K), R3.1; also elsewhere on the board
/bridge driver/HOUT_W: D6.1 (K), R5.1; also elsewhere on the board
/bridge driver/LOUT_U: D3.1 (K), R2.1; also elsewhere on the board
/bridge driver/LOUT_V: D5.1 (K), R4.1; also elsewhere on the board
/bridge driver/LOUT_W: D7.1 (K), R6.1; also elsewhere on the board
unnamed: D2.2 (A), R1.2, R7.2
unnamed: D3.2 (A), R2.2, R8.2
unnamed: D4.2 (A), R3.2, R9.2
unnamed: D5.2 (A), R4.2, R10.2
unnamed: D6.2 (A), R5.2, R11.2
unnamed: D7.2 (A), R6.2, R12.2
unnamed: Q1.1 (G), R7.1
unnamed: Q2.1 (G), R8.1
unnamed: Q3.1 (G), R9.1
unnamed: Q4.1 (G), R10.1
unnamed: Q5.1 (G), R11.1
unnamed: Q6.1 (G), R12.1

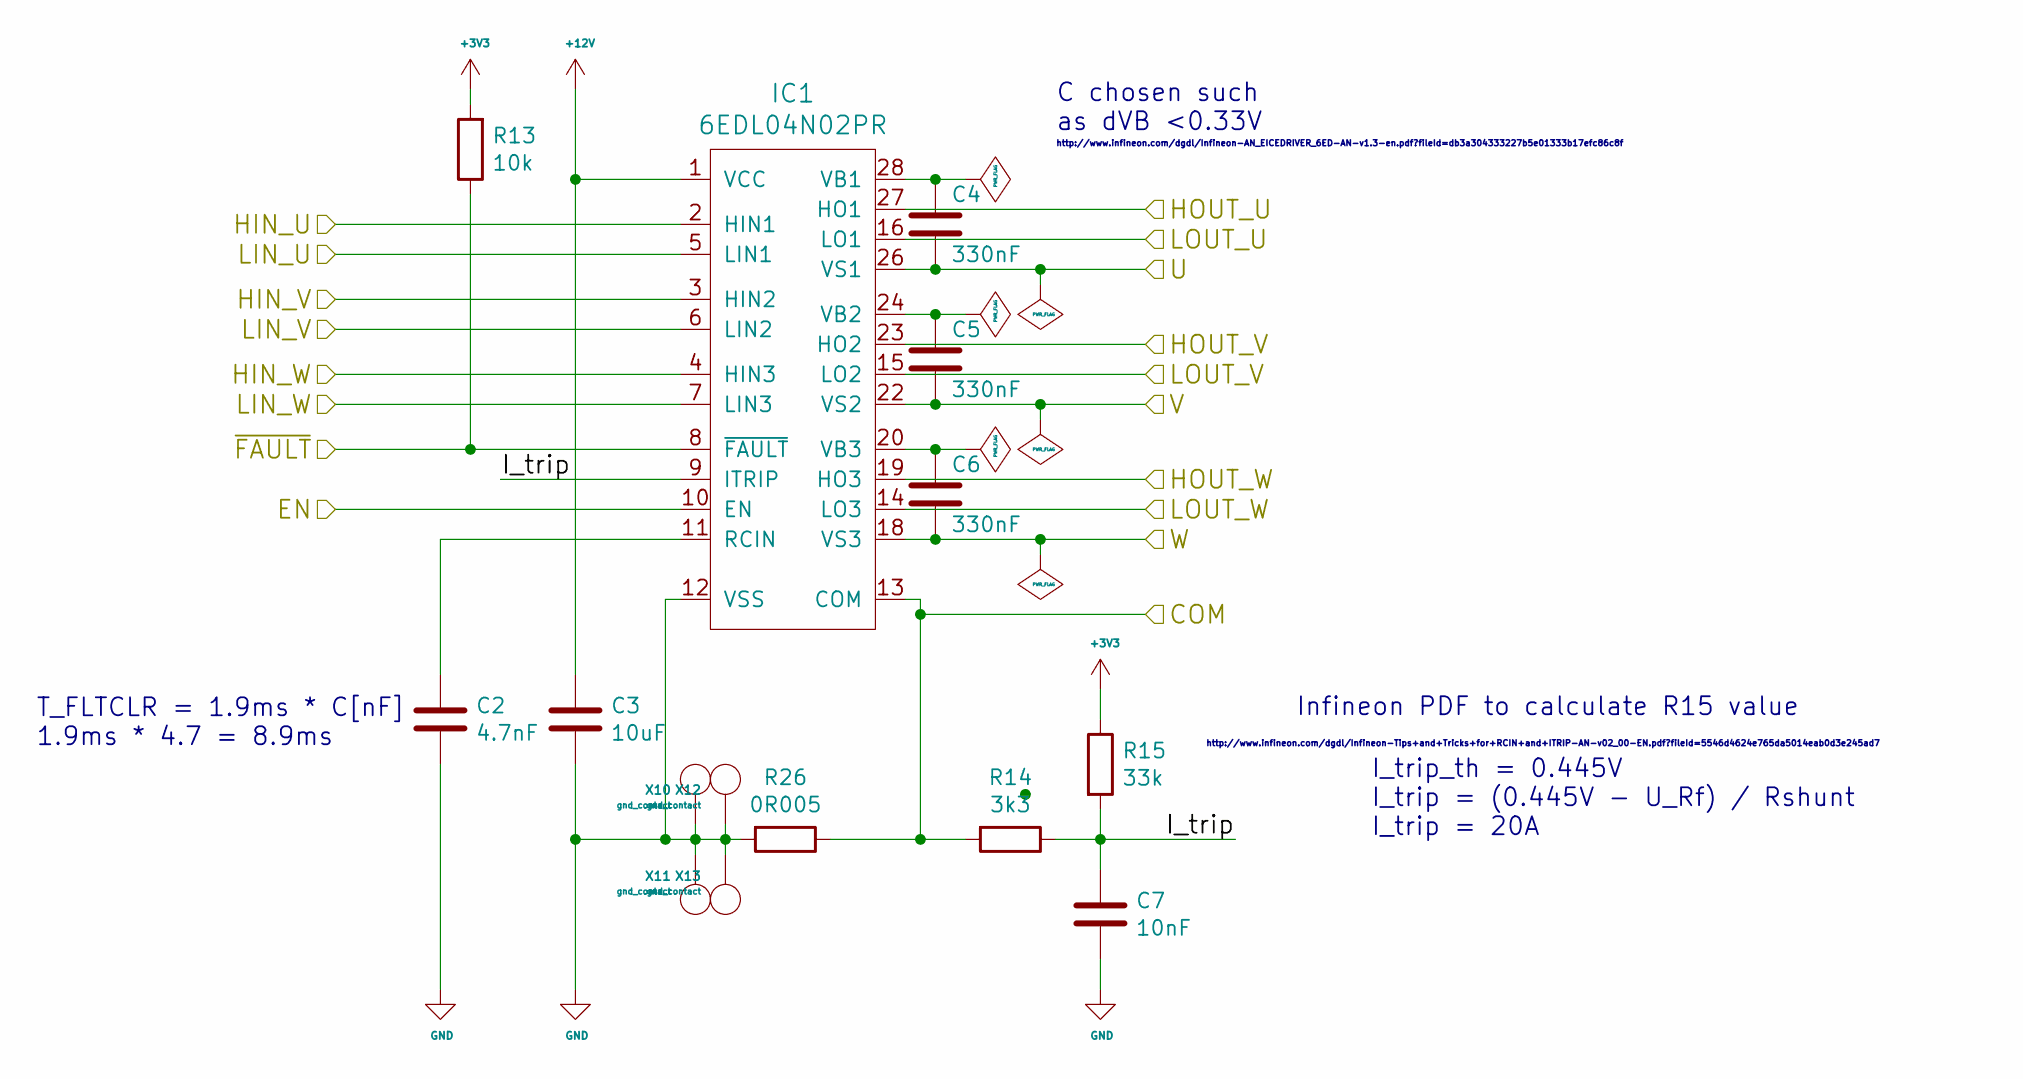
[picture p31: schematic bridge_driver.sch]

Parts:
C2: 4.7nF; C_0603in
C3: 10uF; C_0603in
C4, C5, C6: 330nF; C_0603in
C7: 10nF; C_0603in
IC1: 6EDL04N02PR
R13: 10k; R_0603in
R14: 3k3; R_0603in
R15: 33k; R_0603in
R26: 0R005; R_2512in
X10, X11, X12, X13: gnd_contact; via_0.4mm

Connections:
+3V3: R13.2, R15.1; also elsewhere on the board
+12V: C3.1, IC1.1 (VCC); also elsewhere on the board
/U: C4.2, IC1.26 (VS1); also elsewhere on the board
/V: C5.2, IC1.22 (VS2); also elsewhere on the board
/W: C6.2, IC1.18 (VS3); also elsewhere on the board
/XMC4x00/EN: IC1.10 (EN); also elsewhere on the board
/XMC4x00/~FAULT: IC1.8 (~FAULT), R13.1; also elsewhere on the board
/bridge driver/COM: IC1.13 (COM), R14.2, R26.1; also elsewhere on the board
/bridge driver/HIN_U: IC1.2 (HIN1); also elsewhere on the board
/bridge driver/HIN_V: IC1.3 (HIN2); also elsewhere on the board
/bridge driver/HIN_W: IC1.4 (HIN3); also elsewhere on the board
/bridge driver/HOUT_U: IC1.27 (HO1); also elsewhere on the board
/bridge driver/HOUT_V: IC1.23 (HO2); also elsewhere on the board
/bridge driver/HOUT_W: IC1.19 (HO3); also elsewhere on the board
/bridge driver/I_trip: C7.1, IC1.9 (ITRIP), R14.1, R15.2
/bridge driver/LIN_U: IC1.5 (LIN1); also elsewhere on the board
/bridge driver/LIN_V: IC1.6 (LIN2); also elsewhere on the board
/bridge driver/LIN_W: IC1.7 (LIN3); also elsewhere on the board
/bridge driver/LOUT_U: IC1.16 (LO1); also elsewhere on the board
/bridge driver/LOUT_V: IC1.15 (LO2); also elsewhere on the board
/bridge driver/LOUT_W: IC1.14 (LO3); also elsewhere on the board
GND: C2.2, C3.2, C7.2, IC1.12 (VSS), R26.2, X10.1, X11.1, X12.1, X13.1; also elsewhere on the board
unnamed: C2.1, IC1.11 (RCIN)
unnamed: C4.1, IC1.28 (VB1)
unnamed: C5.1, IC1.24 (VB2)
unnamed: C6.1, IC1.20 (VB3)

Notes on the sheet:
http://www.infineon.com/dgdl/Infineon-Tips+and+Tricks+for+RCIN+and+ITRIP-AN-v02_00-EN.pdf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
Infineon PDF to calculate R15 value
T_FLTCLR = 1.9ms * C[nF] 1.9ms * 4.7 = 8.9ms
C chosen such as dVB <0.33V
I_trip_th = 0.445V I_trip = (0.445V - U_Rf) / Rshunt I_trip = 20A
http://www.infineon.com/dgdl/Infineon-AN_EICEDRIVER_6ED-AN-v1.3-en.pdf?fileId=db3a304333227b5e01333b17efc86c8f

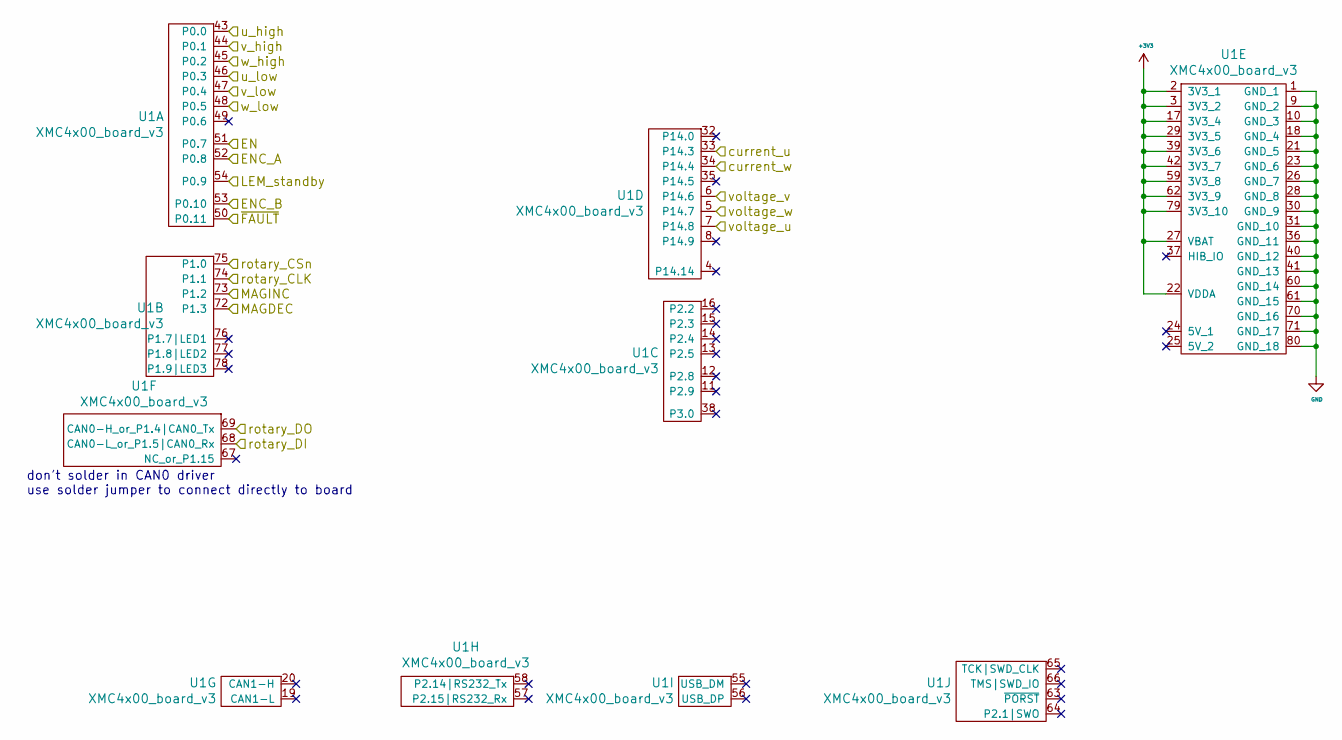
[picture p32: schematic prozessor.sch]

Parts:
U1: XMC4x00_board_v3; XMC4x00-board_v3-0

Connections:
+3V3: U1.2 (3V3_1), U1.3 (3V3_2), U1.17 (3V3_4), U1.22 (VDDA), U1.27 (VBAT), U1.29 (3V3_5), U1.39 (3V3_6), U1.42 (3V3_7), U1.59 (3V3_8), U1.62 (3V3_9), U1.79 (3V3_10); also elsewhere on the board
/LEM_standby: U1.54 (P0.9); also elsewhere on the board
/XMC4x00/EN: U1.51 (P0.7); also elsewhere on the board
/XMC4x00/ENC_A: U1.52 (P0.8); also elsewhere on the board
/XMC4x00/ENC_B: U1.53 (P0.10); also elsewhere on the board
/XMC4x00/MAGDEC: U1.72 (P1.3); also elsewhere on the board
/XMC4x00/MAGINC: U1.73 (P1.2); also elsewhere on the board
/XMC4x00/rotary_CLK: U1.74 (P1.1); also elsewhere on the board
/XMC4x00/rotary_CSn: U1.75 (P1.0); also elsewhere on the board
/XMC4x00/rotary_DI: U1.68 (CAN0-L_or_P1.5|CAN0_Rx); also elsewhere on the board
/XMC4x00/rotary_DO: U1.69 (CAN0-H_or_P1.4|CAN0_Tx); also elsewhere on the board
/XMC4x00/~FAULT: U1.50 (P0.11); also elsewhere on the board
/bridge driver/HIN_U: U1.43 (P0.0); also elsewhere on the board
/bridge driver/HIN_V: U1.44 (P0.1); also elsewhere on the board
/bridge driver/HIN_W: U1.45 (P0.2); also elsewhere on the board
/bridge driver/LIN_U: U1.46 (P0.3); also elsewhere on the board
/bridge driver/LIN_V: U1.47 (P0.4); also elsewhere on the board
/bridge driver/LIN_W: U1.48 (P0.5); also elsewhere on the board
/current_u_amp: U1.33 (P14.3); also elsewhere on the board
/current_w_amp: U1.34 (P14.4); also elsewhere on the board
/voltage_u: U1.7 (P14.8); also elsewhere on the board
/voltage_v: U1.6 (P14.6); also elsewhere on the board
/voltage_w: U1.5 (P14.7); also elsewhere on the board
GND: U1.1 (GND_1), U1.9 (GND_2), U1.10 (GND_3), U1.18 (GND_4), U1.21 (GND_5), U1.23 (GND_6), U1.26 (GND_7), U1.28 (GND_8), U1.30 (GND_9), U1.31 (GND_10), U1.36 (GND_11), U1.40 (GND_12), U1.41 (GND_13), U1.60 (GND_14), U1.61 (GND_15), U1.70 (GND_16), U1.71 (GND_17), U1.80 (GND_18); also elsewhere on the board

Notes on the sheet:
don't solder in CAN0 driver use solder jumper to connect directly to board

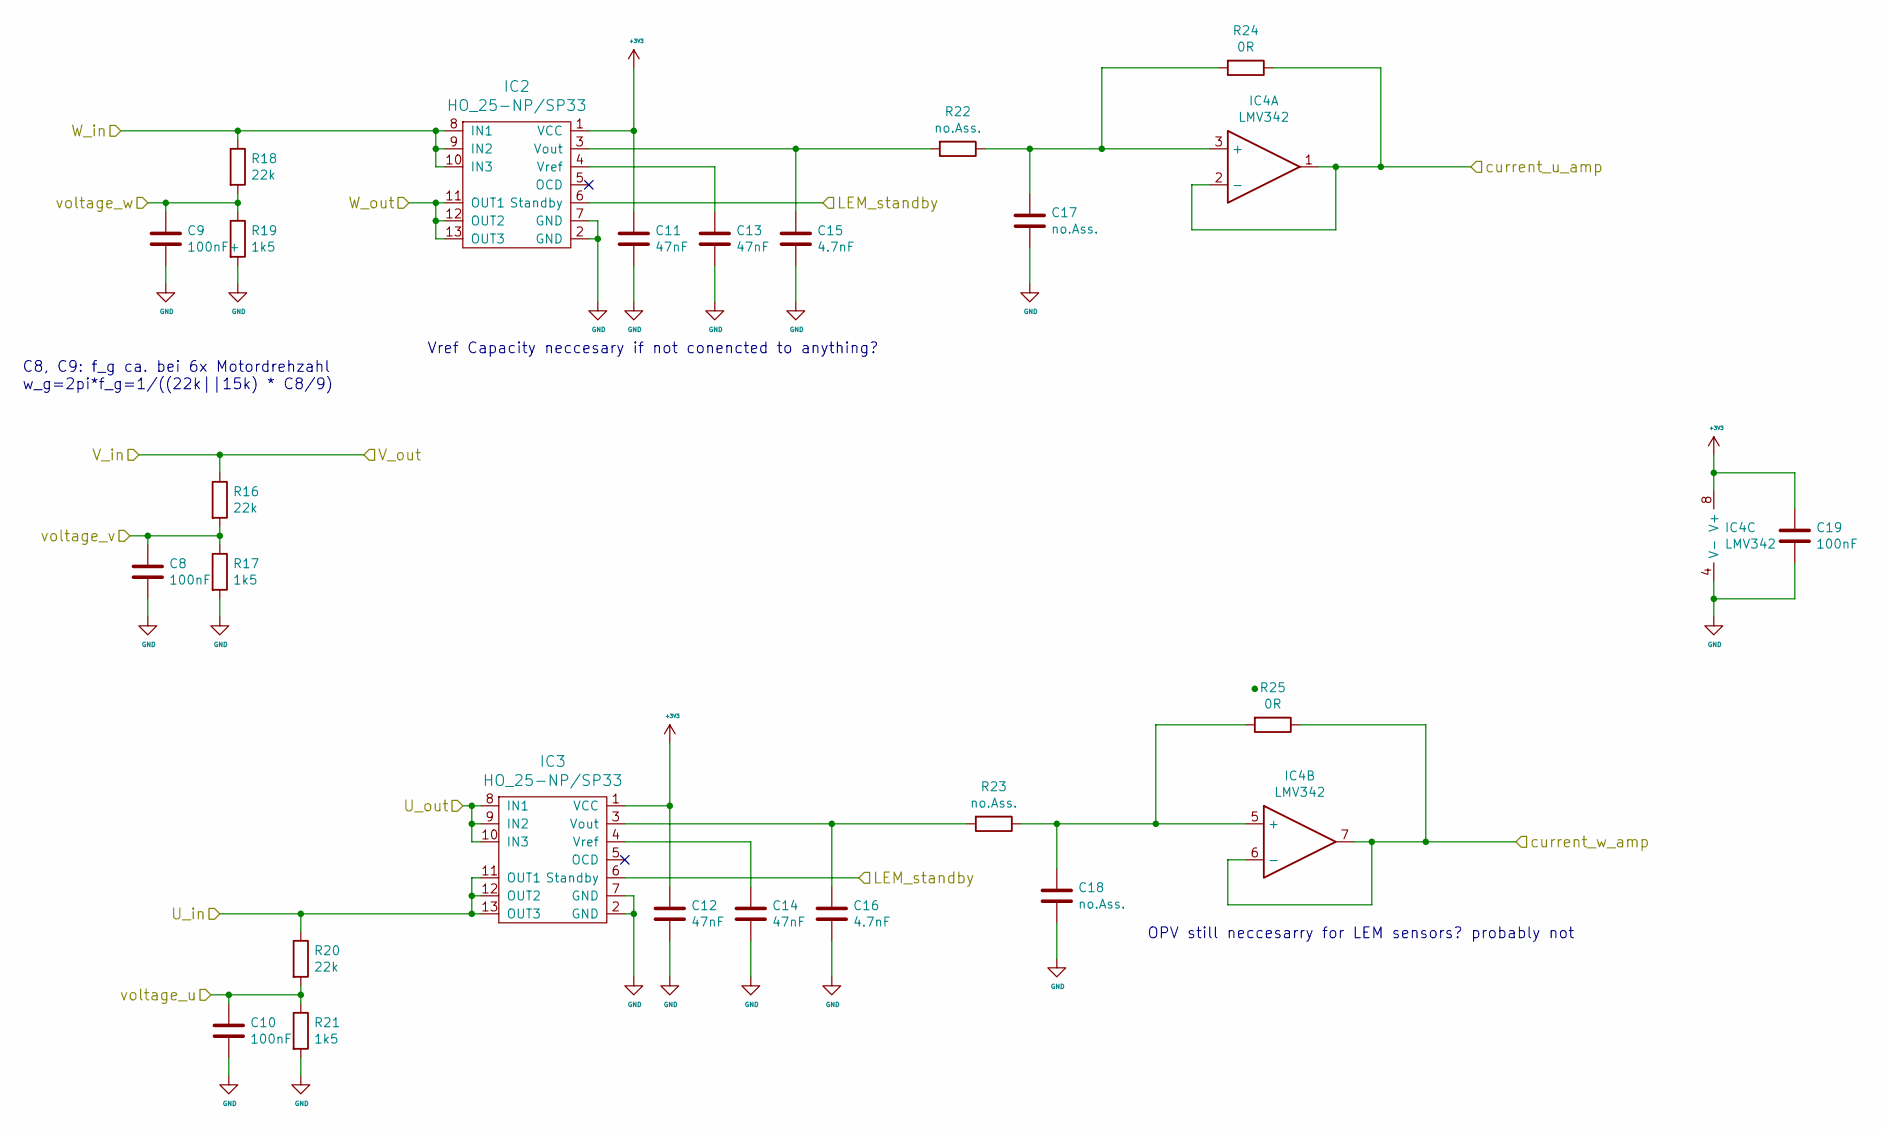
[picture p33: schematic current_amp.sch]

Parts:
C8, C10, C19: 100nF; C_0603in
C9: 100nF+; C_0603in
C11, C12, C13, C14: 47nF; C_0603in
C15, C16: 4.7nF; C_0603in
C17, C18: no.Ass.; C_0603in
IC2, IC3: HO_25-NP/SP33; HO_25-NP_SP33
IC4: LMV342
R16, R18, R20: 22k; R_0603in
R17, R19, R21: 1k5; R_0603in
R22, R23: no.Ass.; R_0603in
R24, R25: 0R; R_0603in

Connections:
+3V3: C11.1, C12.1, C19.1, IC2.1 (VCC), IC3.1 (VCC), IC4.8 (V+); also elsewhere on the board
/LEM_standby: IC2.6 (Standby), IC3.6 (Standby); also elsewhere on the board
/U: IC3.11 (OUT1), IC3.12 (OUT2), IC3.13 (OUT3), R20.1; also elsewhere on the board
/U/I sense/U_out: IC3.8 (IN1), IC3.9 (IN2), IC3.10 (IN3); also elsewhere on the board
/U/I sense/W_out: IC2.11 (OUT1), IC2.12 (OUT2), IC2.13 (OUT3); also elsewhere on the board
/V: R16.1; also elsewhere on the board
/W: IC2.8 (IN1), IC2.9 (IN2), IC2.10 (IN3), R18.1; also elsewhere on the board
/current_u_amp: IC4.1, IC4.2 (-), R24.1; also elsewhere on the board
/current_w_amp: IC4.6 (-), IC4.7, R25.1; also elsewhere on the board
/voltage_u: C10.1, R20.2, R21.1; also elsewhere on the board
/voltage_v: C8.1, R16.2, R17.1; also elsewhere on the board
/voltage_w: C9.1, R18.2, R19.1; also elsewhere on the board
GND: C8.2, C9.2, C10.2, C11.2, C12.2, C13.2, C14.2, C15.2, C16.2, C17.2, C18.2, C19.2, IC2.2 (GND), IC2.7 (GND), IC3.2 (GND), IC3.7 (GND), IC4.4 (V-), R17.2, R19.2, R21.2; also elsewhere on the board
unnamed: C13.1, IC2.4 (Vref)
unnamed: C14.1, IC3.4 (Vref)
unnamed: C15.1, IC2.3 (Vout), R22.2
unnamed: C16.1, IC3.3 (Vout), R23.2
unnamed: C17.1, IC4.3 (+), R22.1, R24.2
unnamed: C18.1, IC4.5 (+), R23.1, R25.2

Notes on the sheet:
OPV still neccesarry for LEM sensors? probably not
Vref Capacity neccesary if not conencted to anything?
C8, C9: f_g ca. bei 6x Motordrehzahl w_g=2pi*f_g=1/((22k||15k) * C8/9)

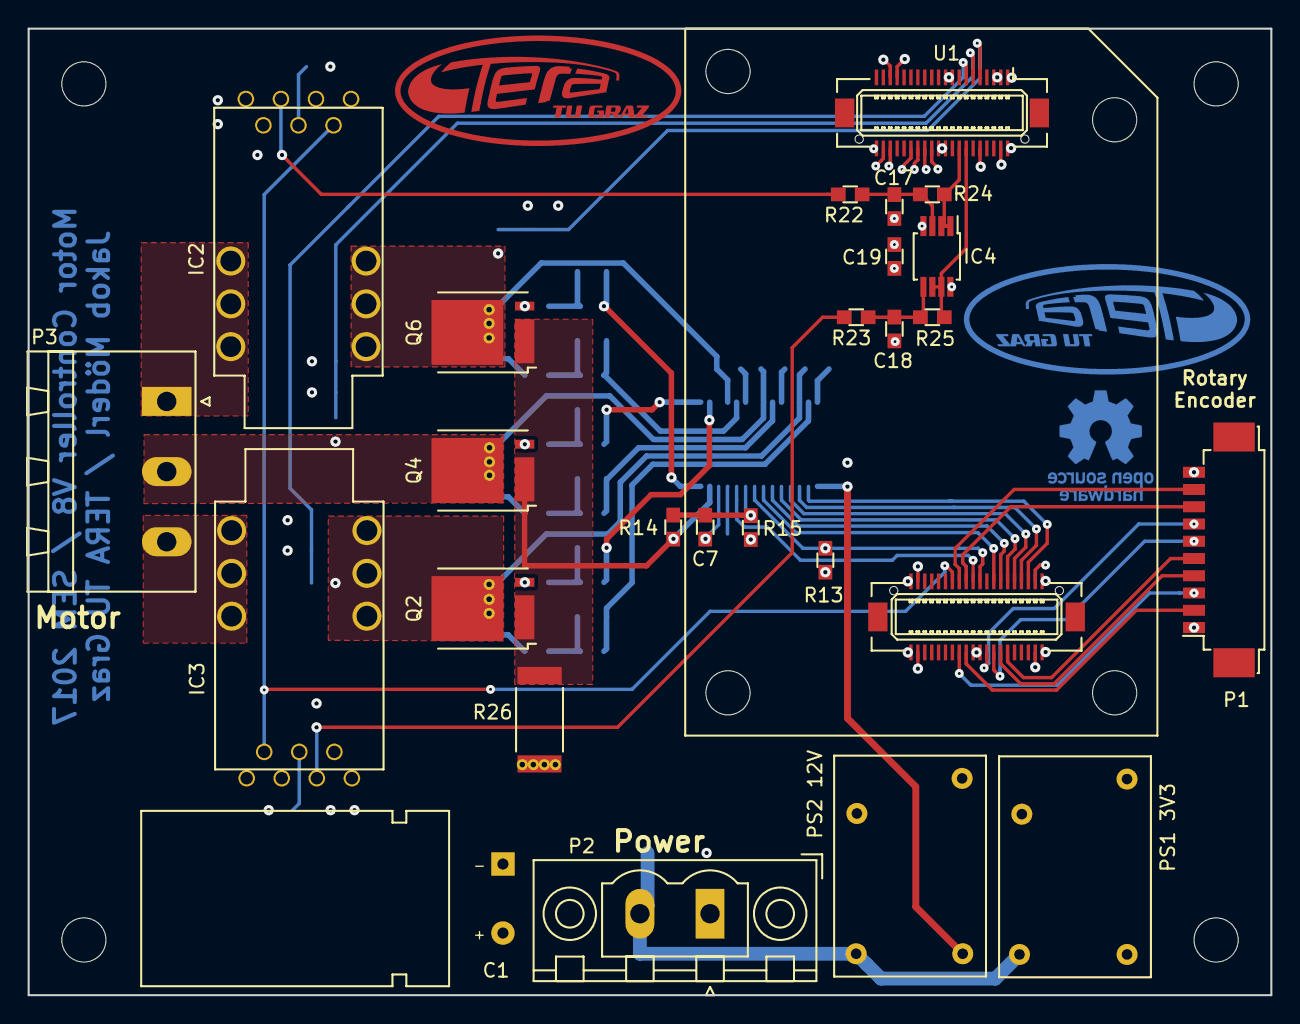
[picture p34: board HW/pcbs/motor/V8/Motor-Control-board-V8_KiCAD/Motor_Control.kicad_pcb from above]

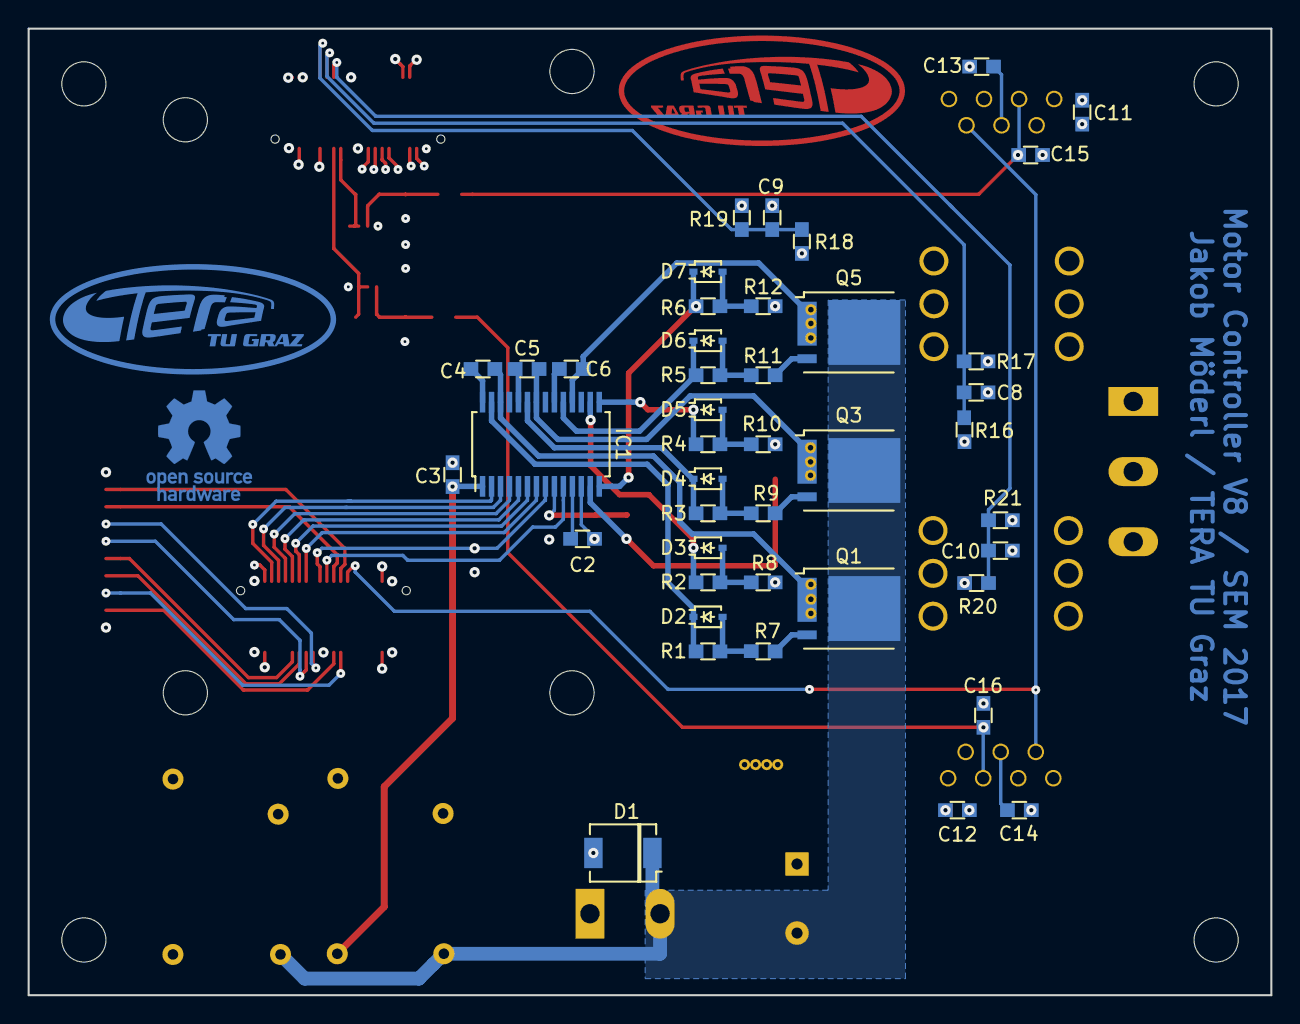
[picture p35: board HW/pcbs/motor/V8/Motor-Control-board-V8_KiCAD/Motor_Control.kicad_pcb from below]

Board: 4 copper layers, 90.0 x 70.0 mm, 83 parts (51 on the bottom side), 61 nets.

Other parts of the board:
svg2mod, svg2mod#2: G***; TERA_Logo_Cu_7.5x19mm
