TERA-TU-Graz/fennek_2019/(notices)

Notices in the files:
HW/pcbs/motor/V8/Motor-Control-board-V8_2_KiCAD/Motor_Control.kicad_pcb:
©2018, Möderl/Pöschl
HW/pcbs/BMS/measurement_and_balancing/bms_board_V6__12s_fennek2017/bms_board.kicad_pcb:
©2017, Pöschl
© Pöschl Rene, Jan. 2017 Solderpad v0.51
HW/pcbs/BMS/power_distribution/fennek_power_distribution_v2/bacup/fennek_power_distribution.kicad_pcb:
© Pöschl Rene,
Mar. 2017 Solderpad v0.51
HW/pcbs/BMS/master_fennek18/BMS_Master_V7 -- fennek18/BMS_Master_V7_kicad.kicad_pcb:
©Pöschl, 2018
©Pöschl, Apr. 2018
HW/pcbs/BMS/power_distribution/fennek_power_distribution_v2/fennek_power_distribution.kicad_pcb:
©Pöschl, Jun.2017
HW/pcbs/motor/V8/Motor-Control-board-V8_1_KiCAD/Motor_Control.kicad_pcb:
©2017, Möderl
HW/pcbs/BMS/measurement_and_balancing/bms_board_V6-1__12s_fennek2017/bms_board.kicad_pcb:
© Pöschl Rene, Mar. 2018 Solderpad v0.51
